sebiik/axoloti-preenfm2/preenfm2-master/hardware/screenshot.1560930870.jpg

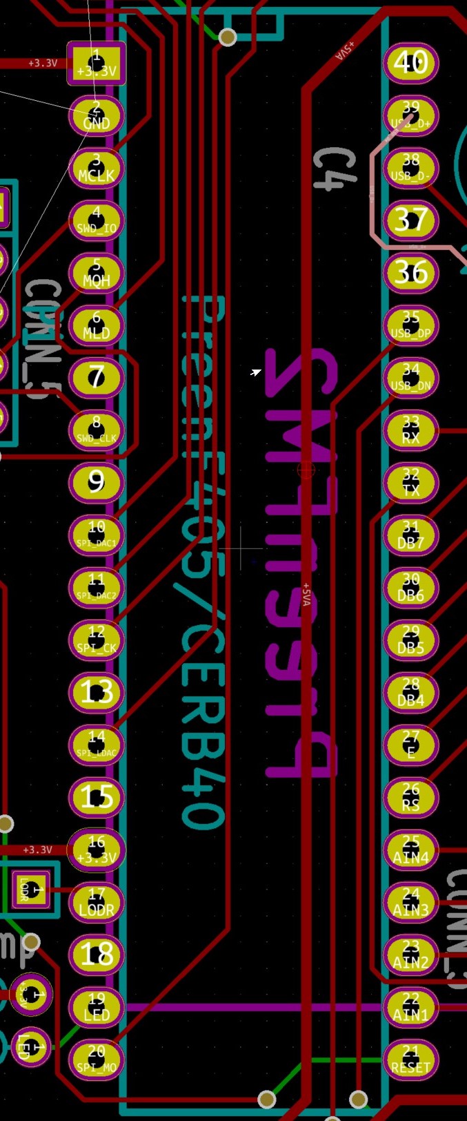
preenfm2-master/hardware/screenshot.1560930870.jpg
