sebiik/axoloti-preenfm2/preenfm2-master/hardware/VanDaalElectronics/20190225_163440.jpg

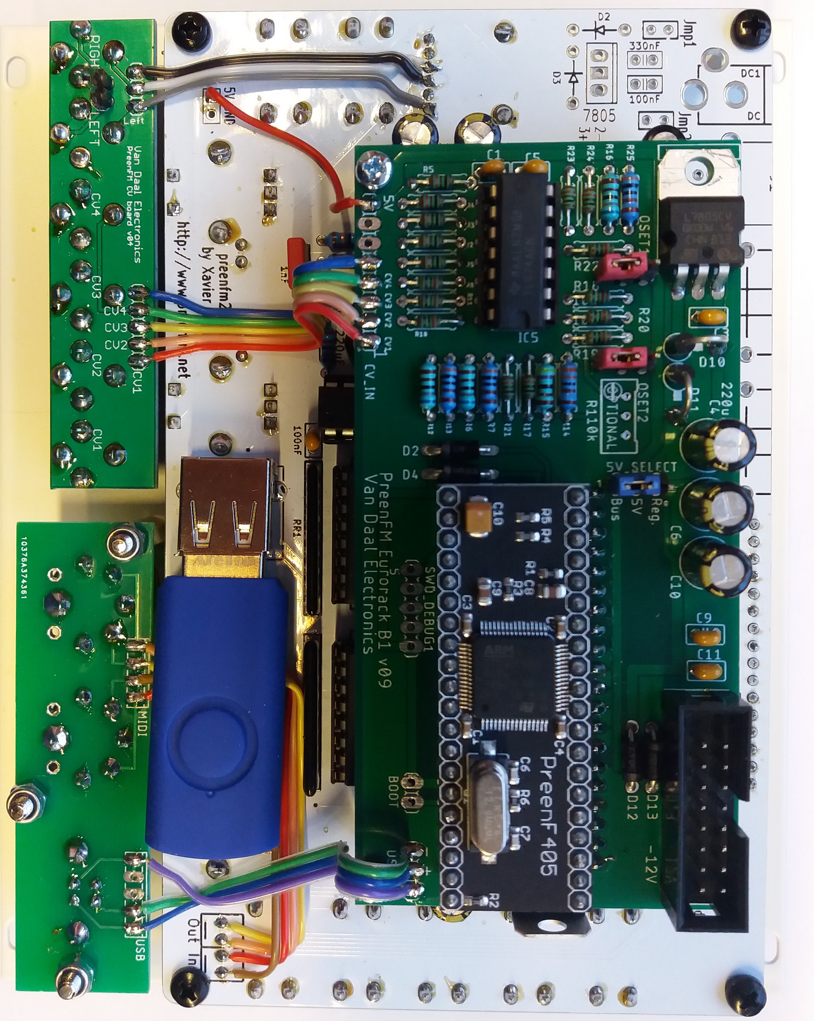
preenfm2-master/hardware/VanDaalElectronics/20190225_163440.jpg
