sebiik/axoloti-preenfm2/README.md

# axoloti-preenfm2

Nothing to see here, carry on.

Edit: Well actually I got Axoloti to work well on the PreenFM2 but it included some nasty hardware hacking and a new, proper DAC chip plugged onto the P405 board, all of which is why I won't release any further info on this project.
