sebiik/axoloti-preenfm2/axo-on-preenfm2-pinout.xlsx

Preen405 PIN | STM32F405 PIN | PREENFM2 FUNCTION | AXOLOTI FUNCTION | NOW HACKED IN
17 | BOOT0 | LOADER (JMP3) | BOOT0
1 | don’t care | 3V3 | 3V3
2 | don’t care | GND | GND
21 | NRST | #RESET | RST
26 | PA0 | LCD_RS | assignable
27 | PA1 | LCD_E | assignable
39 | PA11 | USB_DP | OTG_FS_DP
38 | PA12 | USB_DM | OTG_FS_DM
4 | PA13 | SWDIO | SWDIO
8 | PA14 | SWCLK | SWCLK
28 | PA2 | LCD_DB4 | assignable
29 | PA3 | LCD_DB5 | assignable
30 | PA4 | LCD_DB6 | assignable | now I2S3_WS
31 | PA5 | LCD_DB7 | assignable
6 | PA6 | SPI_MLD | assignable | To 74HC165
5 | PA7 | SPI_MQH | assignable | To 74HC165
3 | PA8 | MCLK | MCLK | To 74HC165
32 | PB10 | TX (MIDI_OUT) | assignable (Header X3) | UART3: DIN MIDI
33 | PB11 | RX (MIDI_IN) | nc | UART3: DIN MIDI
34 | PB14 | USBKey_DN | USB_HOST_DM |  | how to use?
35 | PB15 | USBKey_DP | USB_HOST_DP |  | how to use?
12 | PB3 | SPI_CK | assignable (SPI3_SCK) | now I2S3_CK | Was: MCP4922 SCK
10 | PB4 | SPI_DAC1 | assignable (SPI3_MISO) |  | Was: MCP4922 CS1
20 | PB5 | SPI_MO | Switch 1 (PB5/BOOT0) | now I2S3_SD | Was: MCP4922 MO
19 | PB6 | LED | assignable
18 | PB7 | nc | assignable
16 | PB8 | 3V3 (for board recognition) | assignable (I2C1_SCL)
11 | PB9 | SPI_DAC2 | assignable (I2C1_SDA) |  | Was: MCP4922 CS2
22 | PC0 | assignable(AIN1) | assignable | gate in
23 | PC1 | assignable(AIN2) | assignable | CV in
7 | PC10 | nc | SDIO_D2 | SD card D2
9 | PC11 | nc | SDIO_D3 | SD card D3
14 | PC12 | SPI_LDAC | SDIO_CK | SD card CK | Was: MCP4922 LDAC
15 | PC13 | nc | nc (weak)
24 | PC2 | assignable(AIN3) | assignable
25 | PC3 | assignable(AIN4) | assignable
36 | PC6 | nc | nc | now LCD_DB6
37 | PC7 | nc | nc | now I2S3_MCK
40 | PC8 | nc | SDIO_D0 | SD card D0
13 | PD2 | nc | SDIO_CMD | SD card CMD
*41 | PC9 | Pull-up | SDIO_D1 | SD card D1
 |  |  |  |  |  | D2 | D3 | CMD | VSS | VDD | CLK | VSS | D0 | D1
 |  |  |  |  |  |  | 1 | 2 | 3 | 4 | 5 | 6 | 7 | 8
 |  |  |  |  |  | 9
 |  |  |  |  |  |  |  |  | SD CARD
