sebiik/axoloti-preenfm2/preenfm2-master/hardware/preenF405/Preen40.pdf

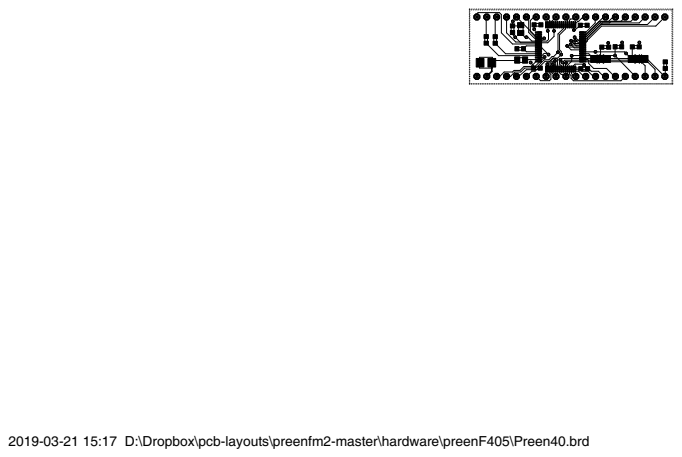
[picture p12: page 1]

2019-03-21 15:17 D:\Dropbox\pcb-layouts\preenfm2-master\hardware\preenF405\Preen40.brd
