sebiik/axoloti-preenfm2/preenfm2-master/hardware/VanDaalElectronics/CV_converter_v06.brd.pdf

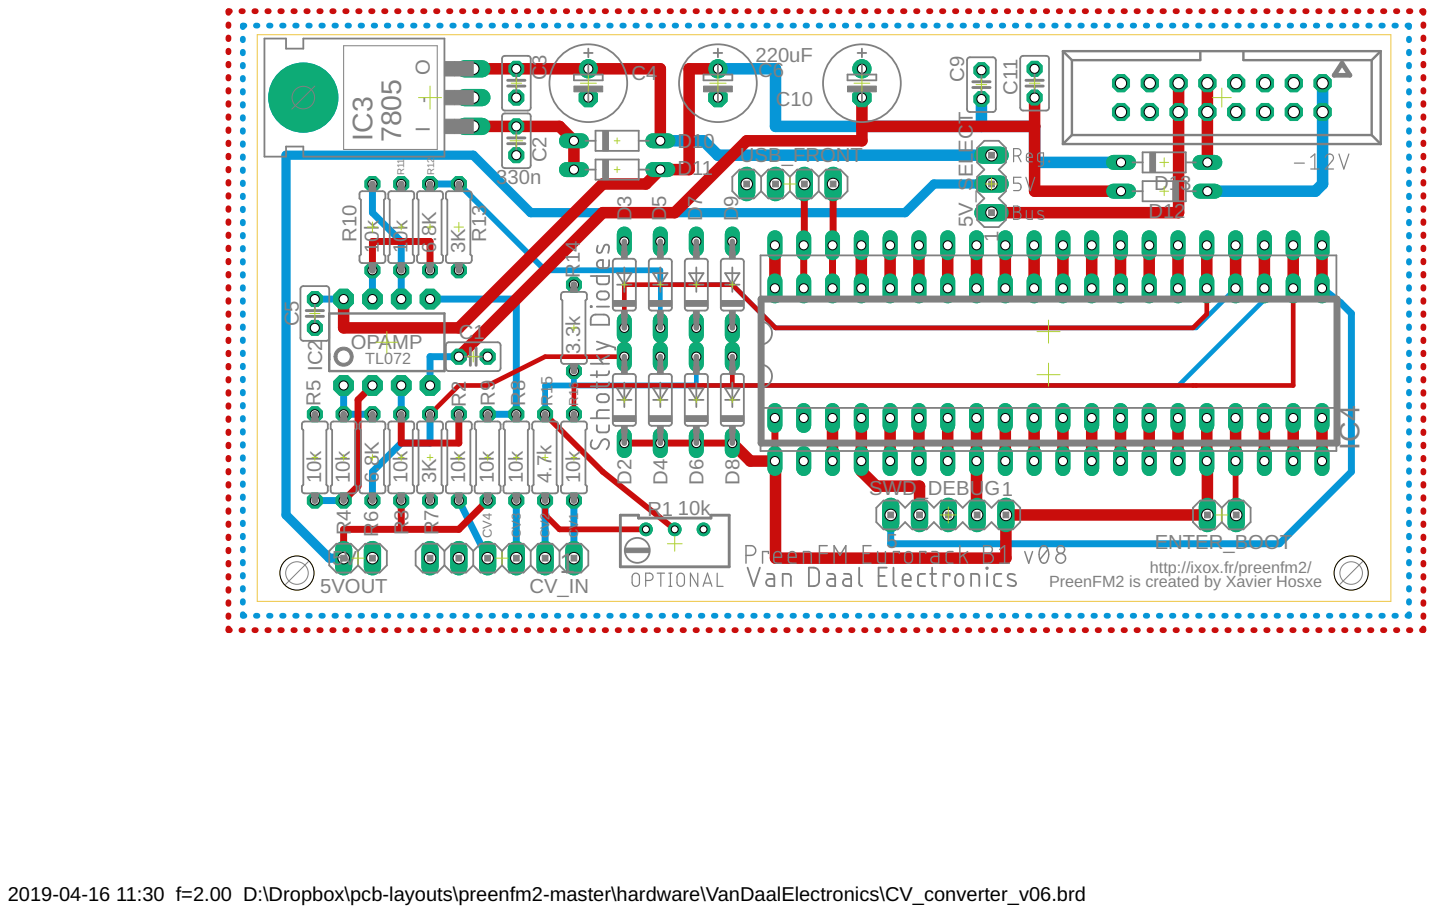
[picture p13: page 1]

PreenFM2 is created by Xavier Hosxe

2019-04-16 11:30 f=2.00 D:\Dropbox\pcb-layouts\preenfm2-master\hardware\VanDaalElectronics\CV_converter_v06.brd
