sebiik/axoloti-preenfm2/_done/kicad-cs4354-daughterboard/cs4354-daughterboard.pdf

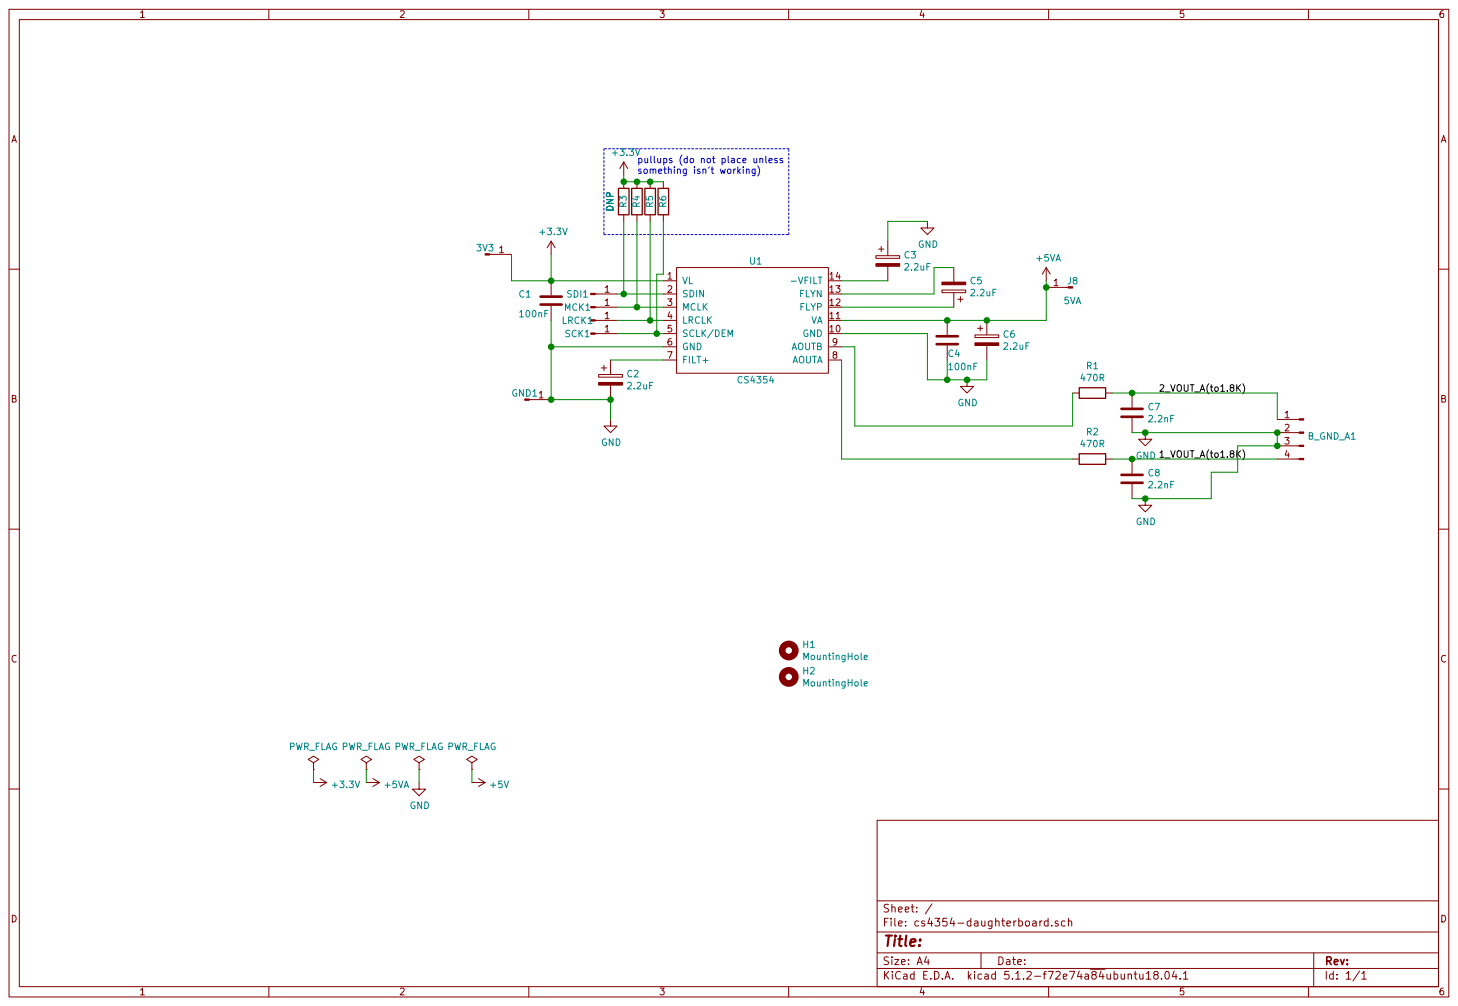
[picture p14: page 1]

something isn't working) +3.3V
pullups (do not place unless

File: cs4354-daughterboard.sch Sheet: /
Id: 1/1 Title:
