sebiik/axoloti-preenfm2/preenfm2-master/hardware/preenF405/Preen40_schem.pdf

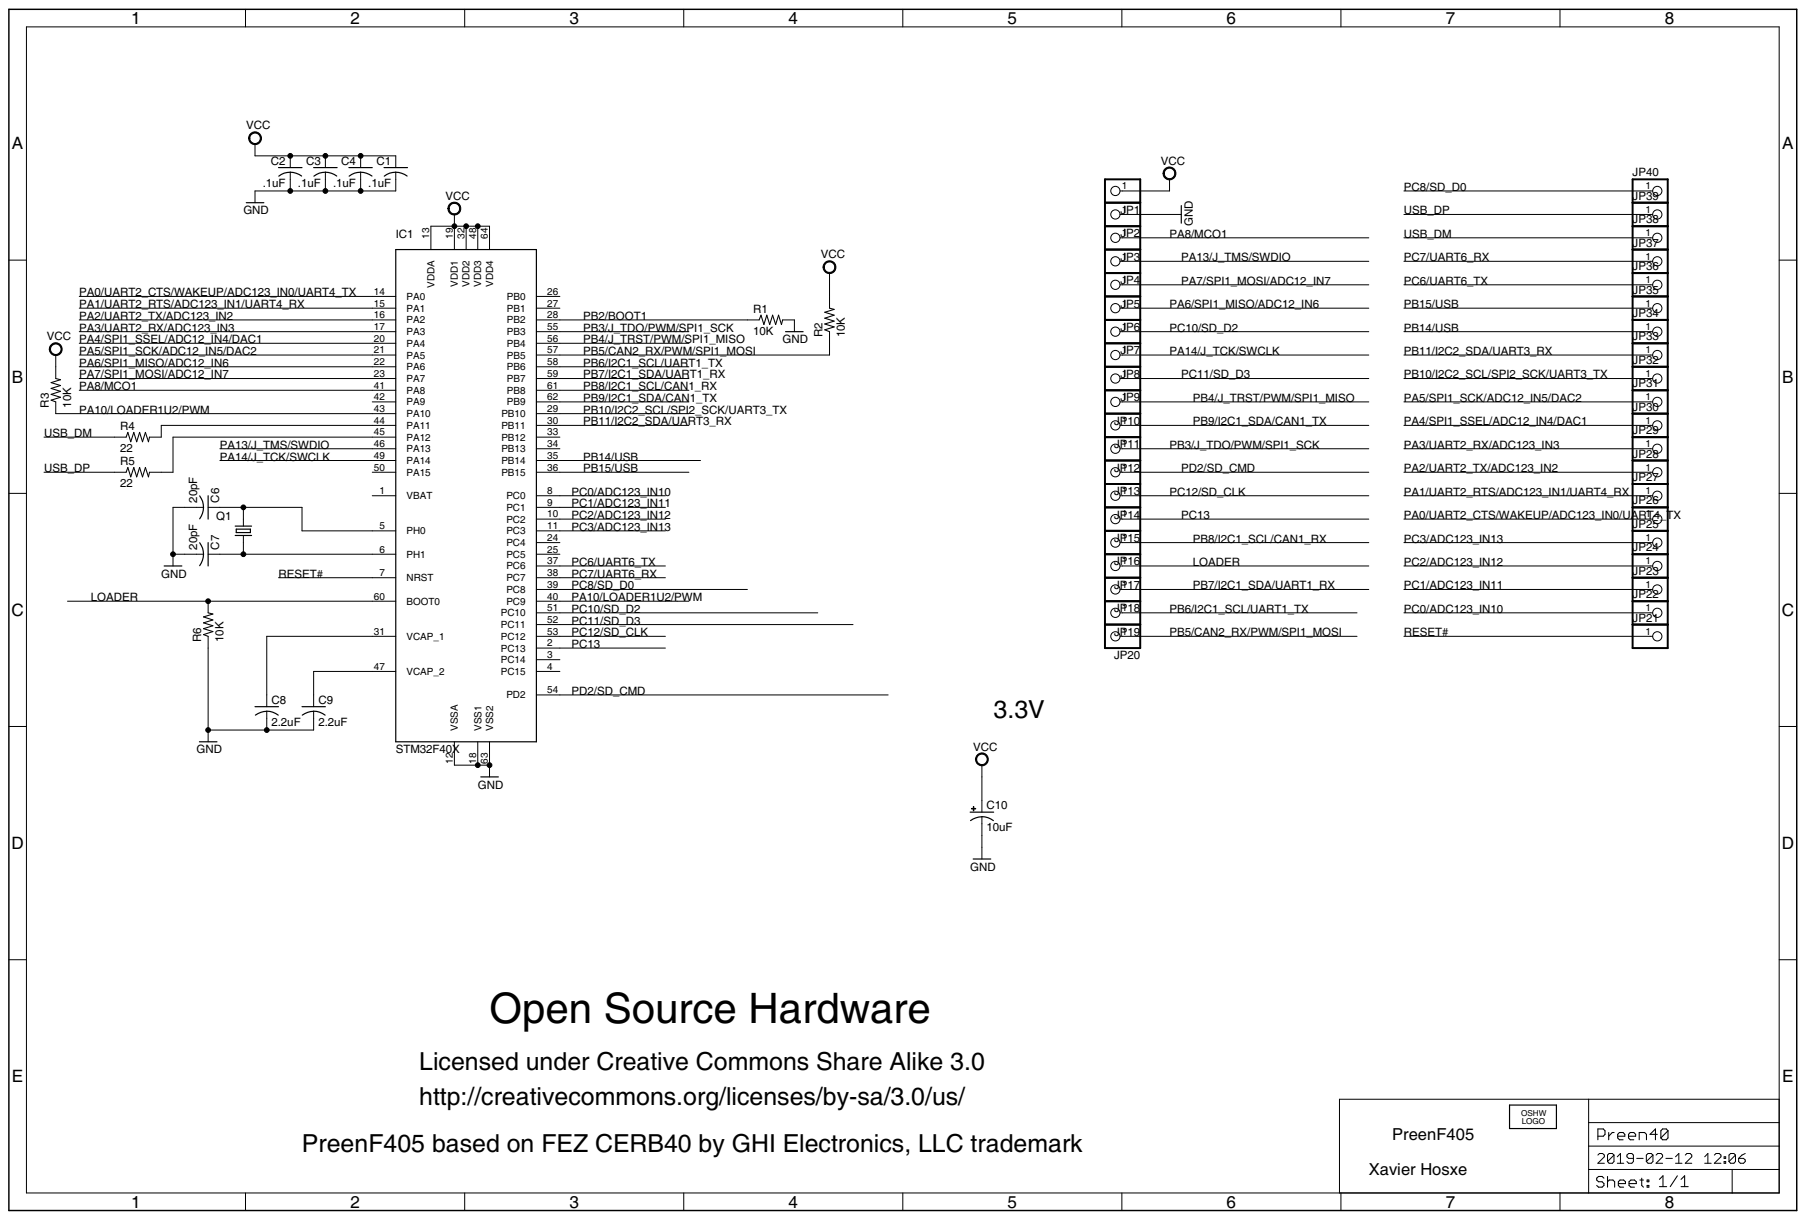
[picture p15: page 1]

Xavier Hosxe Open Source Hardware

Licensed under Creative Commons Share Alike 3.0
http://creativecommons.org/licenses/by-sa/3.0/us/

PreenF405 based on FEZ CERB40 by GHI Electronics, LLC trademark
