sebiik/axoloti-preenfm2/preenfm2-master/hardware/VanDaalElectronics/CV_converter_v06.sch.pdf

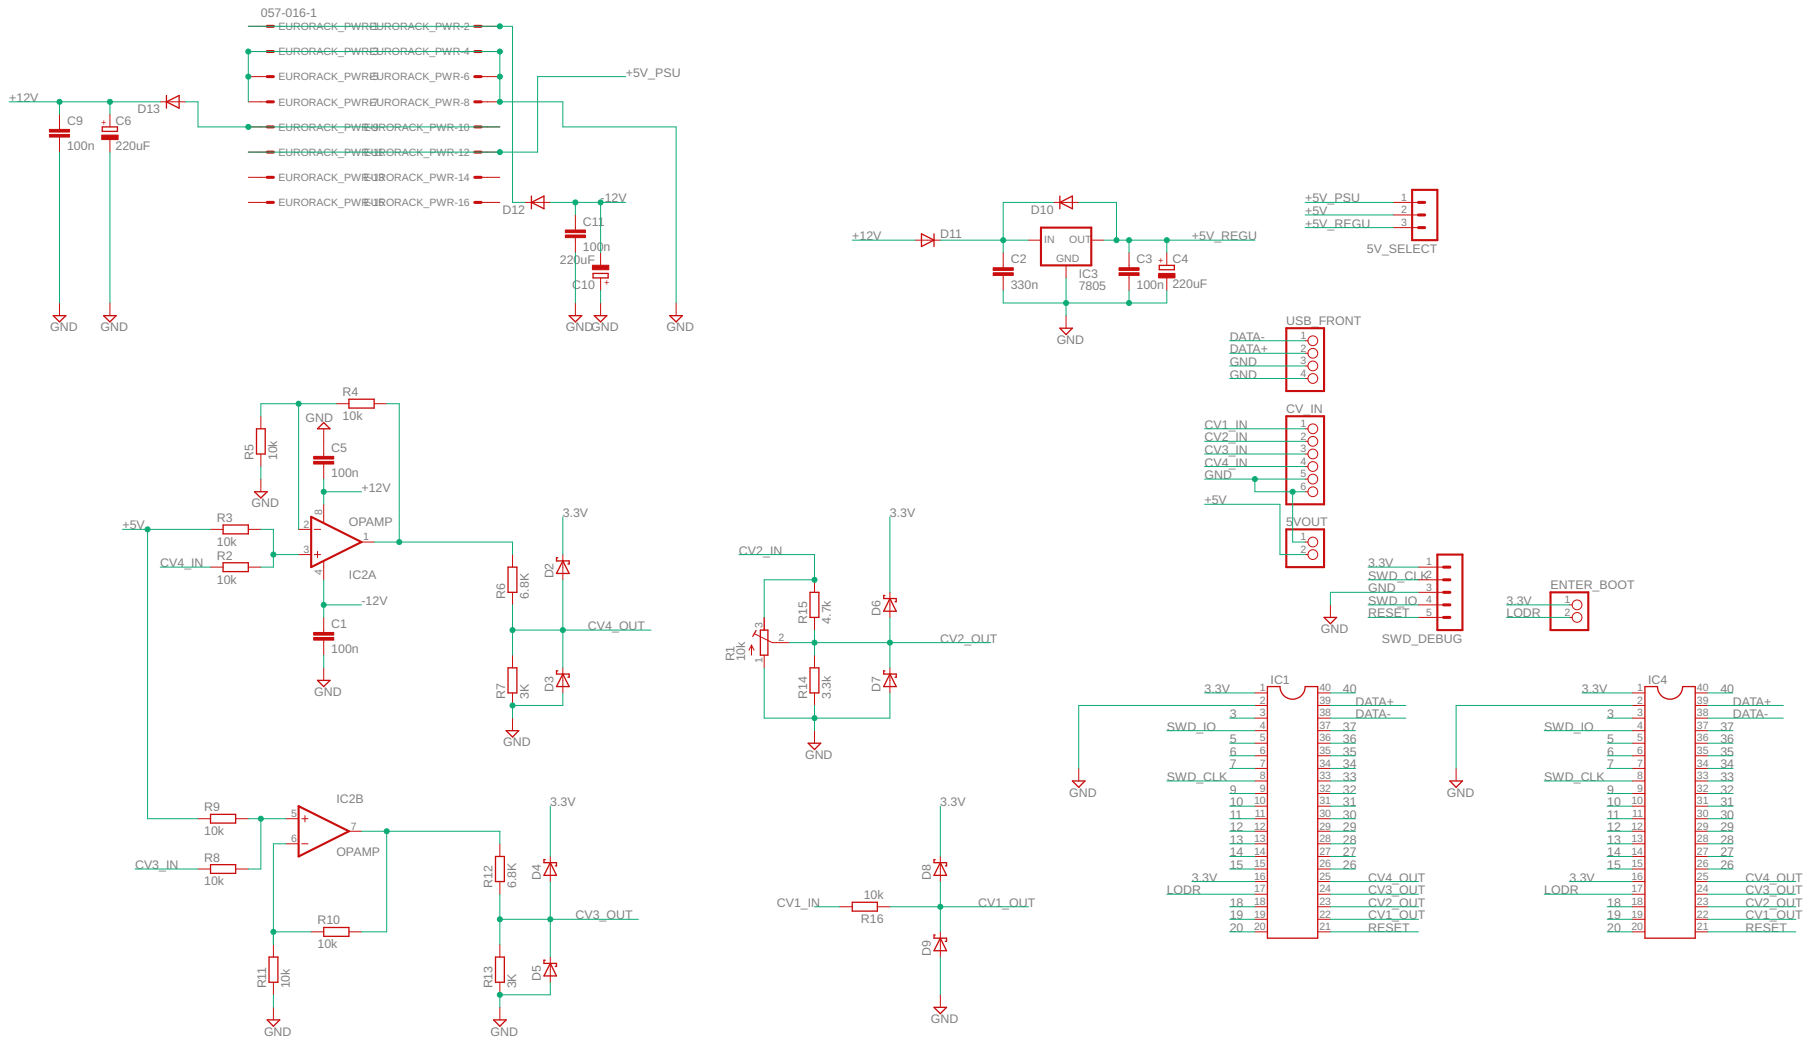
[picture p16: page 1]
