sebiik/axoloti-preenfm2/preenfm2-master/preenfm2-pcb.pdf

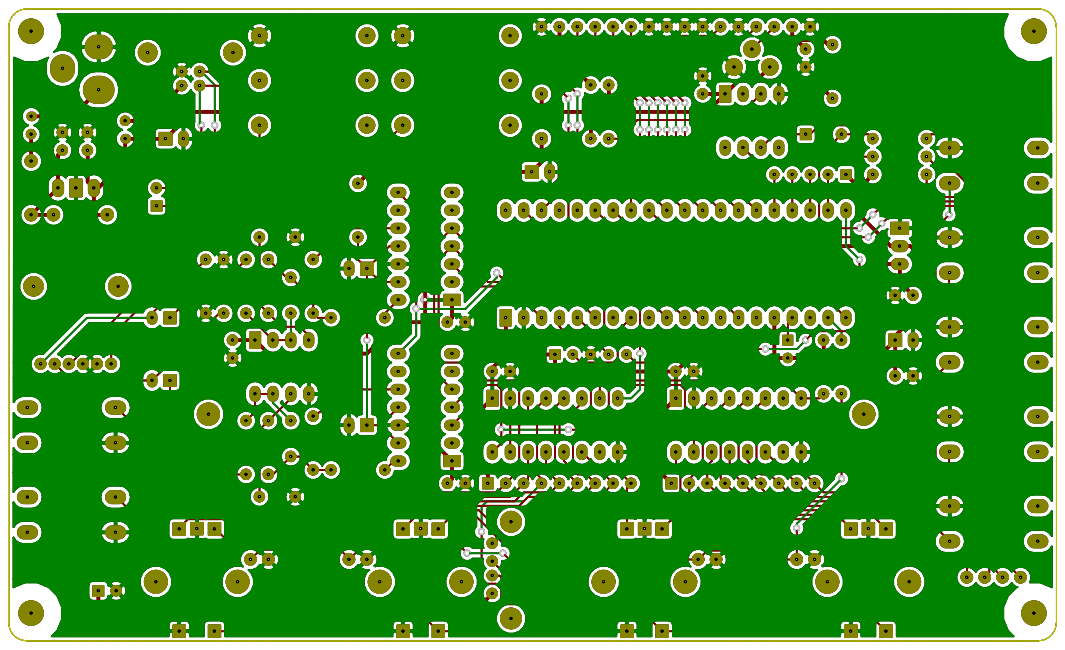
[picture p17: page 1]
