sebiik/axoloti-preenfm2/preenfm2-master/preenfm2-schem.pdf

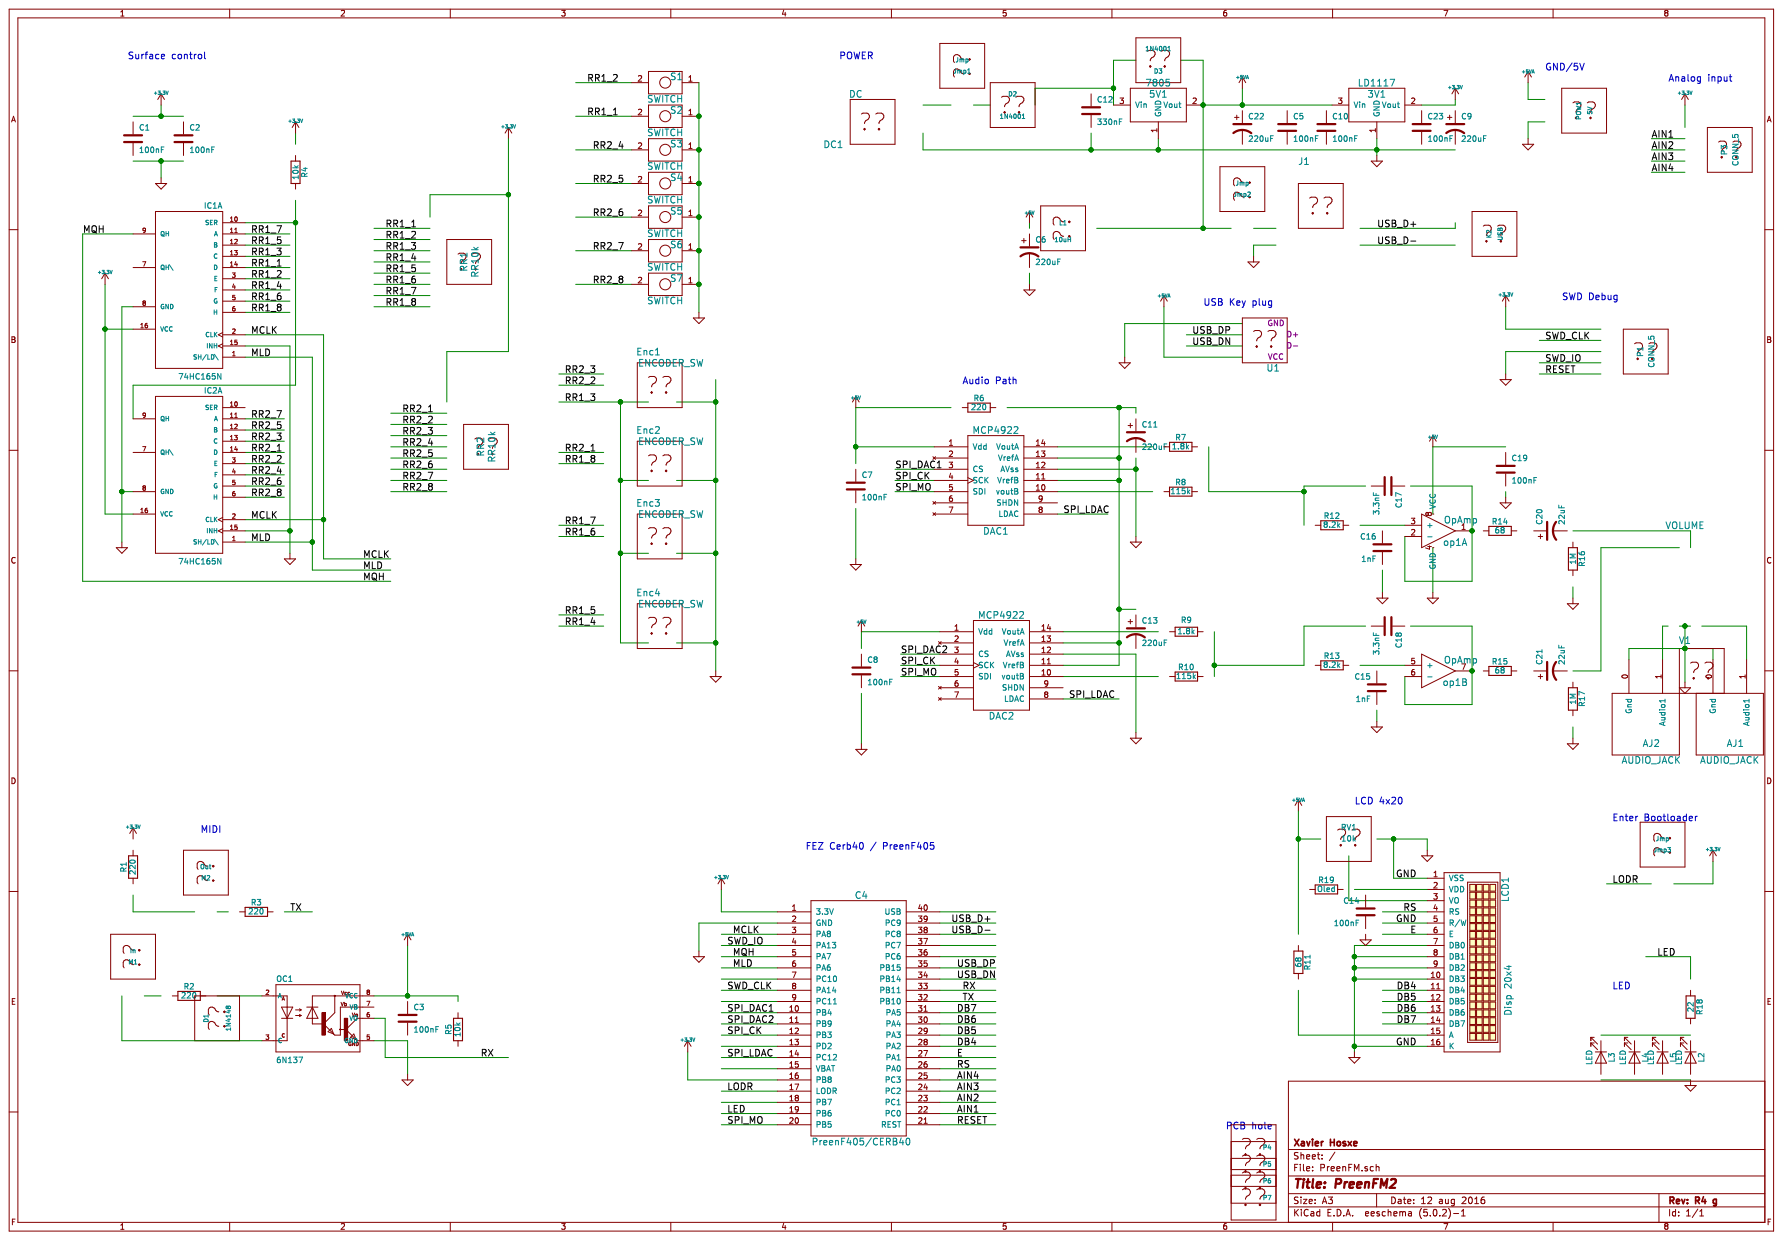
[picture p18: page 1]
