sebiik/axoloti-preenfm2/_done/kicad-cs4354-daughterboard/gerber/cs4354-daughterboard-B_Cu.pdf

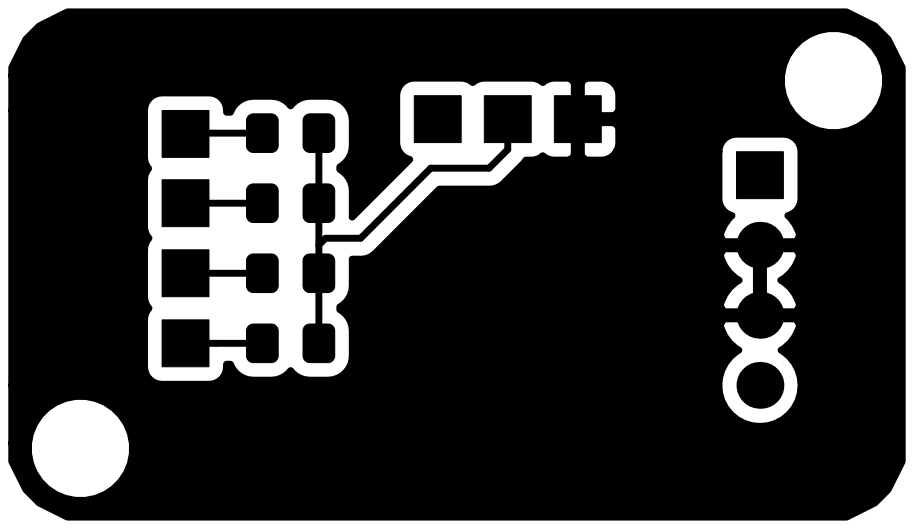
[picture p19: page 1]
