sebiik/axoloti-preenfm2/_done/kicad-cs4354-daughterboard/gerber/cs4354-daughterboard-B_Mask.pdf

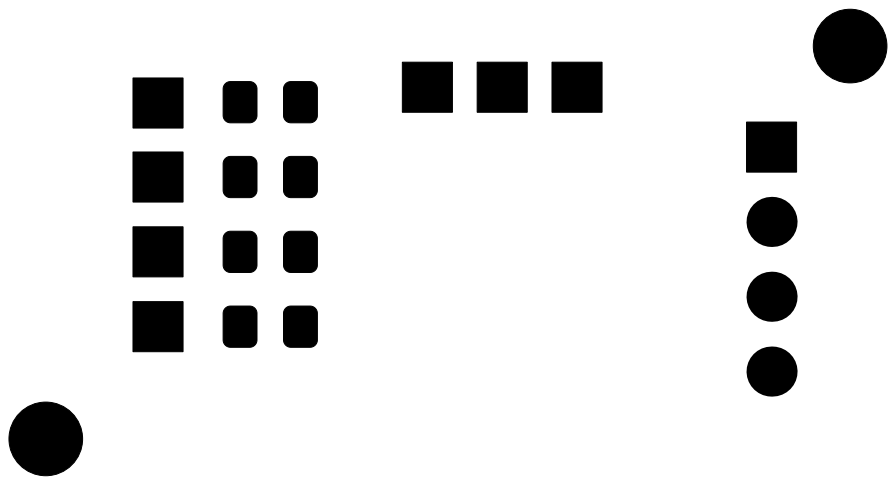
[picture p20: page 1]
