sebiik/axoloti-preenfm2/_done/kicad-cs4354-daughterboard/gerber/cs4354-daughterboard-B_Paste.pdf

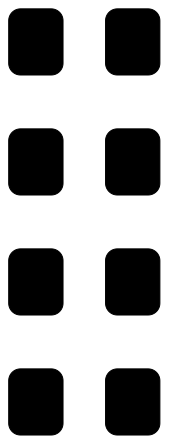
[picture p21: page 1]
