sebiik/axoloti-preenfm2/_done/kicad-cs4354-daughterboard/gerber/cs4354-daughterboard-B_SilkS.pdf

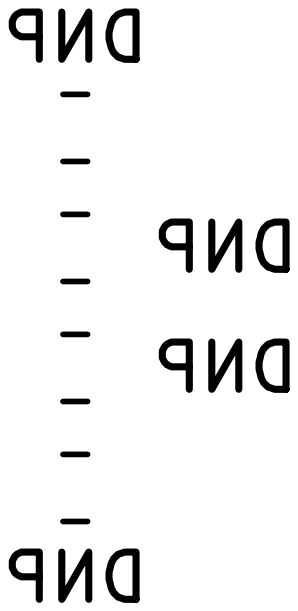
[picture p22: page 1]

DNP DNP
