sebiik/axoloti-preenfm2/_done/kicad-cs4354-daughterboard/gerber/cs4354-daughterboard-Edge_Cuts.pdf

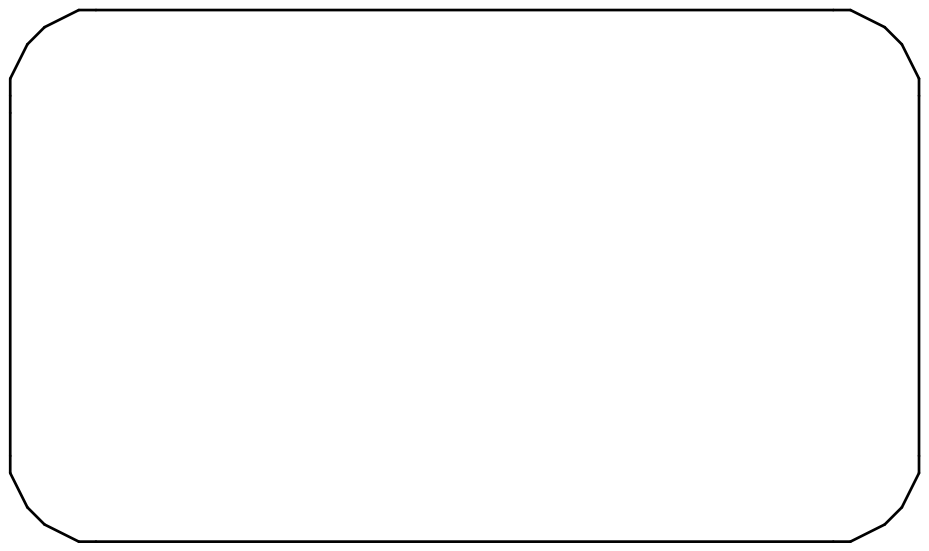
[picture p23: page 1]
