sebiik/axoloti-preenfm2/_done/kicad-cs4354-daughterboard/gerber/cs4354-daughterboard-F_Cu.pdf

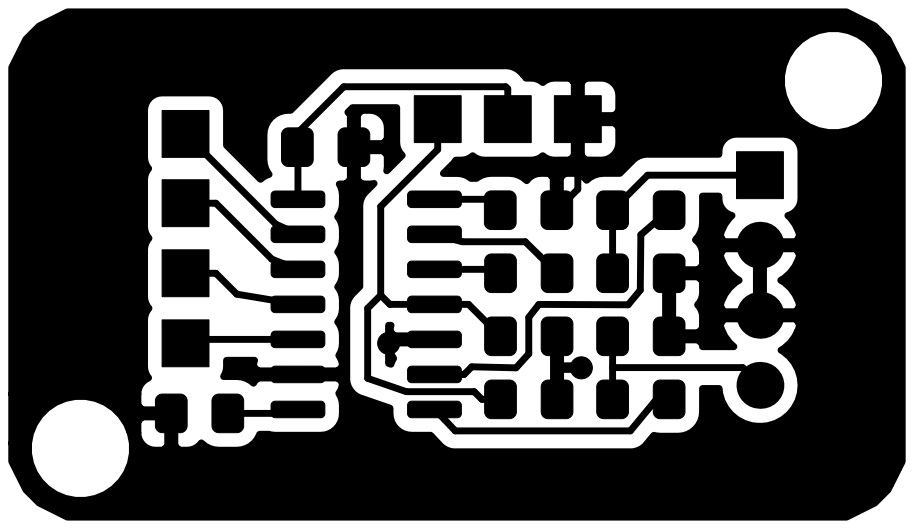
[picture p24: page 1]
