sebiik/axoloti-preenfm2/_done/kicad-cs4354-daughterboard/gerber/cs4354-daughterboard-F_Mask.pdf

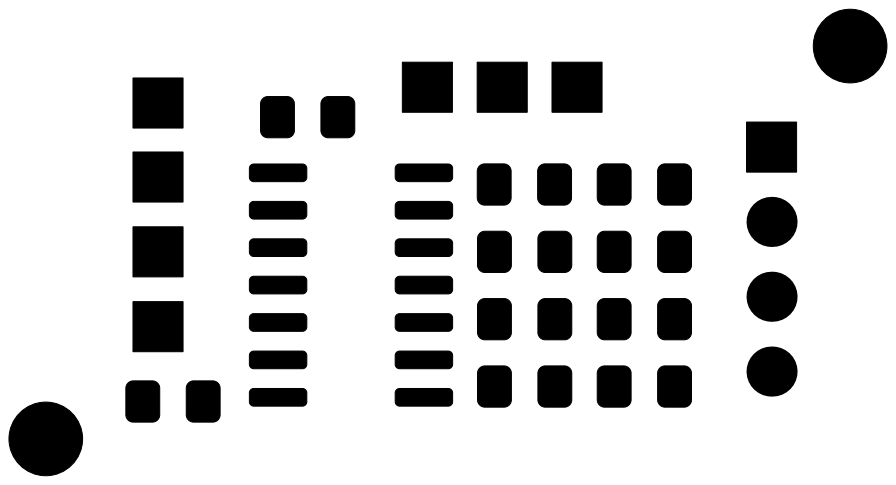
[picture p25: page 1]
