sebiik/axoloti-preenfm2/_done/kicad-cs4354-daughterboard/gerber/cs4354-daughterboard-F_Paste.pdf

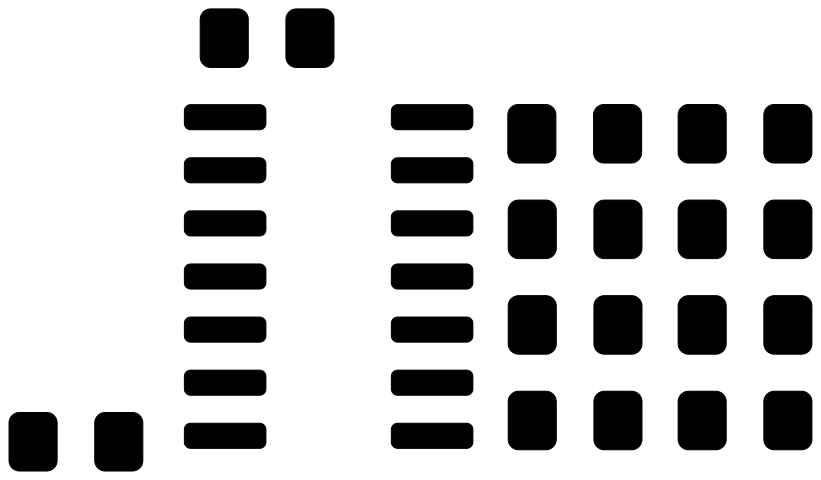
[picture p26: page 1]
