sebiik/axoloti-preenfm2/_done/kicad-cs4354-daughterboard/gerber/cs4354-daughterboard-F_SilkS.pdf

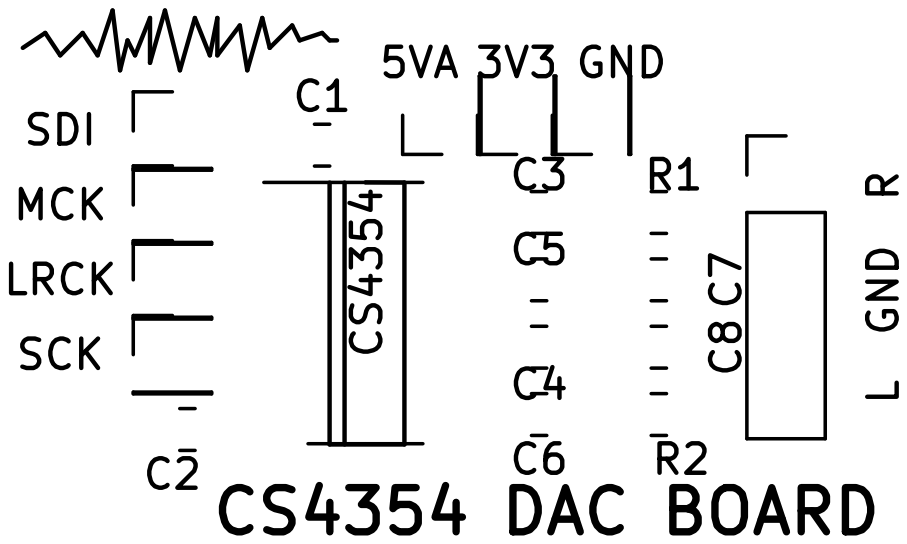
[picture p27: page 1]
