sebiik/axoloti-preenfm2/_done/kicad-cs4354-daughterboard/cs4354-daughterboard.kicad_pcb

## KiCad design _done/kicad-cs4354-daughterboard/cs4354-daughterboard.kicad_pcb (2019-07-05)

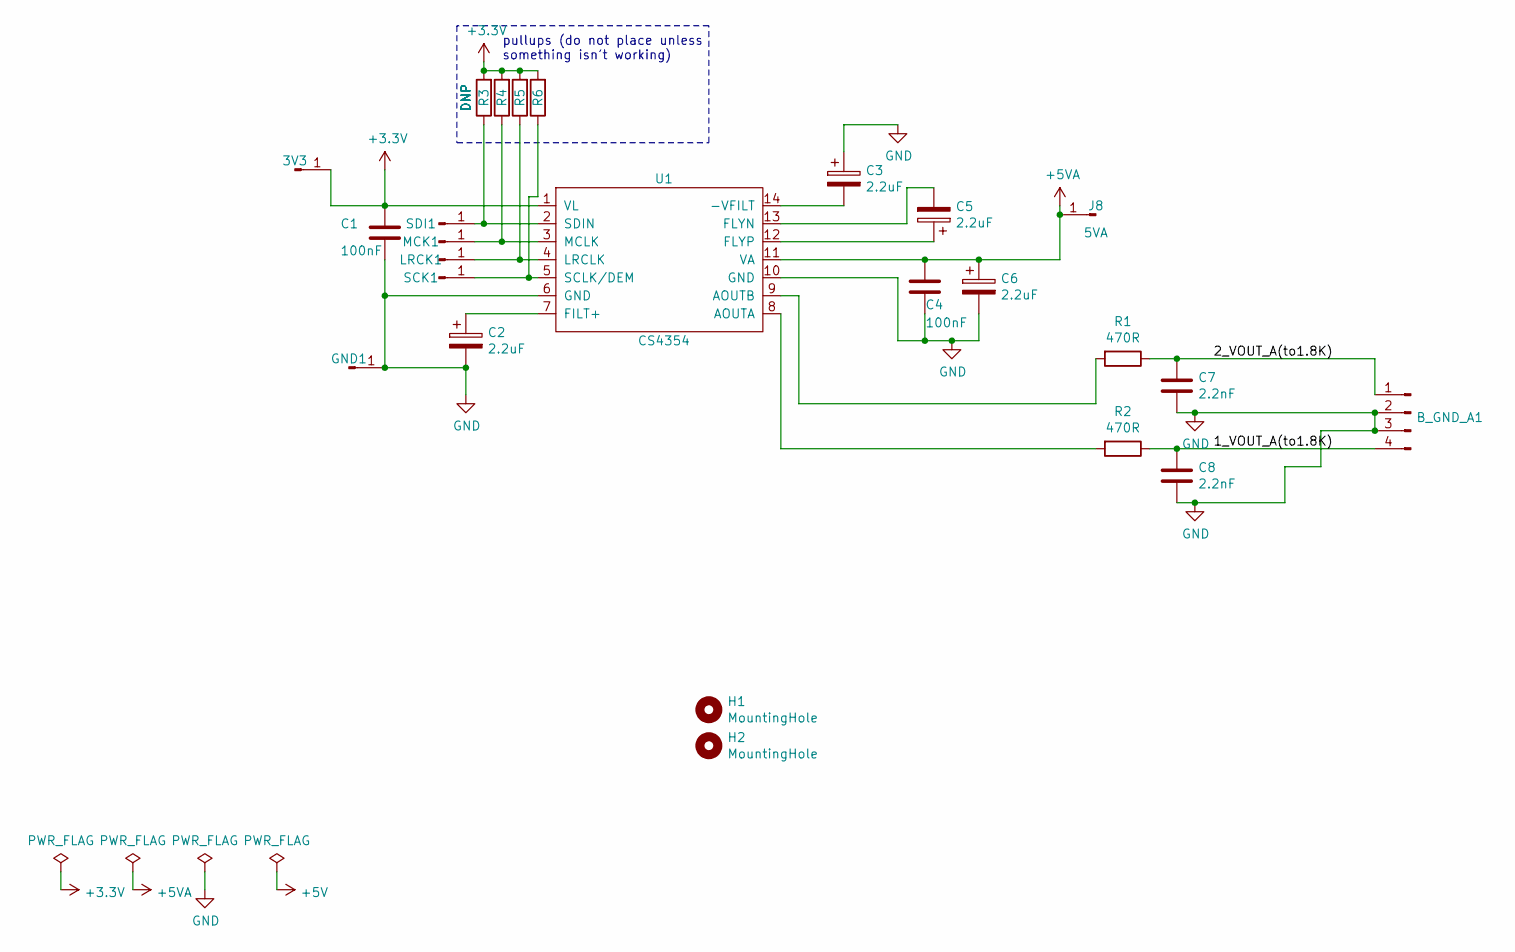
[picture p28: schematic cs4354-daughterboard.sch]

Parts:
3V3: 3V3; PinHeader_1x01_P2.54mm_Vertical
B_GND_A1: L GND R; PinHeader_1x04_P2.54mm_Vertical
C1, C4: 100nF; C_0805_2012Metric_Pad1.15x1.40mm_HandSolder
C2, C3, C5, C6: 2.2uF; C_0805_2012Metric_Pad1.15x1.40mm_HandSolder
C7, C8: 2.2nF; C_0805_2012Metric_Pad1.15x1.40mm_HandSolder
GND1: GND; PinHeader_1x01_P2.54mm_Vertical
H1, H2: MountingHole; MountingHole_2.5mm
J8: 5VA; PinHeader_1x01_P2.54mm_Vertical
LRCK1: LRCK; PinHeader_1x01_P2.54mm_Vertical
MCK1: MCK; PinHeader_1x01_P2.54mm_Vertical
R1, R2: 470R; R_0805_2012Metric_Pad1.15x1.40mm_HandSolder
R3, R4, R5, R6: DNP; R_0805_2012Metric_Pad1.15x1.40mm_HandSolder
SCK1: SCK; PinHeader_1x01_P2.54mm_Vertical
SDI1: SDI; PinHeader_1x01_P2.54mm_Vertical
U1: CS4354; SOIC-14_3.9x8.7mm_P1.27mm

Connections:
+3V3: 3V3.1, C1.1, R3.2, R4.2, R5.2, R6.2, U1.1 (VL)
+5VA: C4.1, C6.1, J8.1, U1.11 (VA)
/1_VOUT_A(to1.8K): B_GND_A1.4, C8.1, R2.1
/2_VOUT_A(to1.8K): B_GND_A1.1, C7.1, R1.1
GND: B_GND_A1.2, B_GND_A1.3, C1.2, C2.2, C3.1, C4.2, C6.2, C7.2, C8.2, GND1.1, U1.6 (GND), U1.10 (GND)
unnamed: C2.1, U1.7 (FILT+)
unnamed: C3.2, U1.14 (-VFILT)
unnamed: C5.1, U1.12 (FLYP)
unnamed: C5.2, U1.13 (FLYN)
unnamed: LRCK1.1, R5.1, U1.4 (LRCLK)
unnamed: MCK1.1, R4.1, U1.3 (MCLK)
unnamed: R1.2, U1.9 (AOUTB)
unnamed: R2.2, U1.8 (AOUTA)
unnamed: R3.1, SDI1.1, U1.2 (SDIN)
unnamed: R6.1, SCK1.1, U1.5 (SCLK/DEM)

Notes on the sheet:
pullups (do not place unless something isn't working)

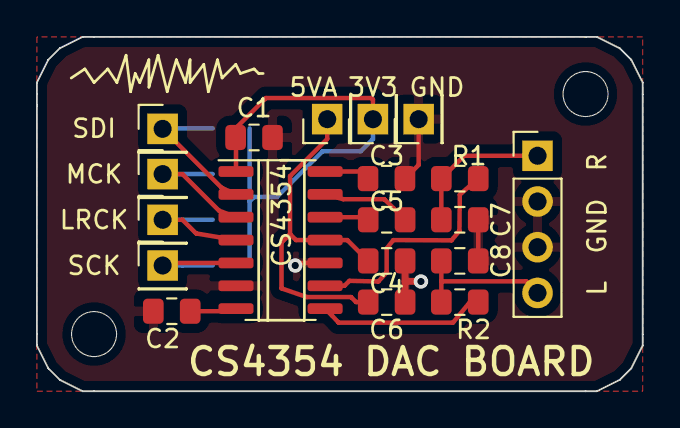
[picture p29: board cs4354-daughterboard.kicad_pcb from above]

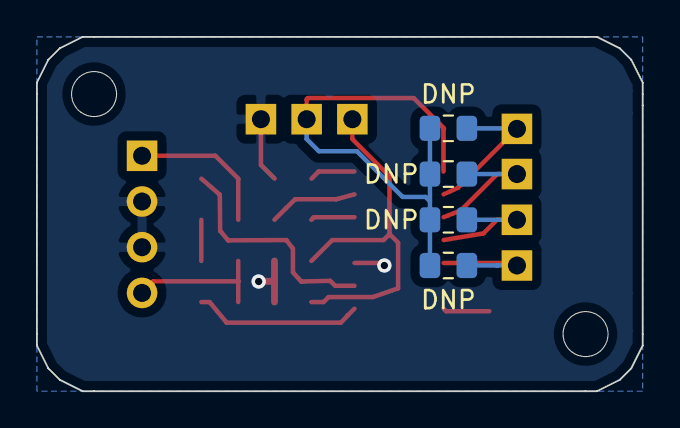
[picture p30: board cs4354-daughterboard.kicad_pcb from below]

Board: 2 copper layers, 33.7 x 19.7 mm, 25 parts (4 on the bottom side), 15 nets.
