sebiik/axoloti-preenfm2/preenfm2-master/hardware/PCB/PreenFM.kicad_pcb

## KiCad design preenfm2-master/hardware/PCB/PreenFM.kicad_pcb (2019-07-02)

Schematic: PreenFM.sch, PreenFM2

Parts:
3V1: LD1117
5V1: 7805
AJ1, AJ2: AUDIO_JACK
C1, C2, C3, C5, C7, C8, C10, C14, C19, C23: 100nF
C4: PreenF405/CERB40
C6, C9, C11, C13, C22: 220uF
C12: 330nF
C15, C16: 1nF
C17, C18: 3.3nF
C20, C21: 22uF
D1: 1N4148
D2, D3: 1N4001
DAC1, DAC2: MCP4922
DC1: DC
Enc1, Enc2, Enc3, Enc4: ENCODER_SW
IC1, IC2: 74HC165N; 74xx-eu-DIL16
J1: USB_1
Jmp1, Jmp2, Jmp3: Jmp
K2: USB
L1: 10uH
L2, L3, L4, L5: LED
LCD1: Disp 20x4
M1: In
M2: Out
OC1: 6N137; optocoupler-DIL08
P1, P3: CONN_5
P4, P5, P6, P7: CONN_1
POW1: 5V
R1, R2, R3, R6: 220
R4, R5: 10k
R7, R9: 1.8k
R8, R10: 115k
R11, R14, R15: 68
R12, R13: 8.2k
R16, R17: 1M
R18: 22
R19: Oled
RR1, RR2: RR10k
RV1: 10k
S1, S2, S3, S4, S5, S6, S7: SWITCH
U1: USBKey
V1: VOLUME
op1: OpAmp

Connections:
+3.3V: 3V1.2 (Vout), C1.1, C2.1, C4.1 (3.3V), C4.16 (PB8), C9.1, C23.1, IC1.16 (VCC), IC2.16 (VCC), Jmp3.2, P1.1, P3.1, R1.2, R4.1, RR1.1, RR2.1
+5V: C6.1, C7.1, C8.1, C19.1, DAC1.1 (Vdd), DAC2.1 (Vdd), L1.2, R6.1, op1.8 (VCC)
+5VA: 3V1.3 (Vin), 5V1.2 (Vout), C3.1, C5.1, C10.1, C22.1, D3.1 (K), Jmp2.1, L1.1, OC1.8 (VCC), POW1.1, R5.2, R11.2, R19.2, RV1.3, U1.1
/AIN1: C4.22 (PC0), P3.2
/AIN2: C4.23 (PC1), P3.3
/AIN3: C4.24 (PC2), P3.4
/AIN4: C4.25 (PC3), P3.5
/DB4: C4.28 (PA2), LCD1.11 (DB4)
/DB5: C4.29 (PA3), LCD1.12 (DB5)
/DB6: C4.30 (PA4), LCD1.13 (DB6)
/DB7: C4.31 (PA5), LCD1.14 (DB7)
/E: C4.27 (PA1), LCD1.6 (E)
/LED: C4.19 (PB6), R18.1
/LODR: C4.17 (LODR), Jmp3.1
/MCLK: C4.3 (PA8), IC1.2 (CLK), IC2.2 (CLK)
/MLD: C4.6 (PA6), IC1.1 (SH/LD\), IC2.1 (SH/LD\)
/MQH: C4.5 (PA7), IC1.9 (QH)
/RESET: C4.21 (REST), P1.5
/RR1_1: IC1.14 (D), RR1.2, S2.2
/RR1_2: IC1.3 (E), RR1.3, S1.2
/RR1_3: Enc1.3, Enc2.3, Enc3.3, Enc4.3, IC1.13 (C), RR1.4
/RR1_4: Enc4.2 (Pin2), IC1.4 (F), RR1.5
/RR1_5: Enc4.0 (Pin1), IC1.12 (B), RR1.6
/RR1_6: Enc3.2 (Pin2), IC1.5 (G), RR1.7
/RR1_7: Enc3.0 (Pin1), IC1.11 (A), RR1.8
/RR1_8: Enc2.2 (Pin2), IC1.6 (H), RR1.9
/RR2_1: Enc2.0 (Pin1), IC2.14 (D), RR2.2
/RR2_2: Enc1.2 (Pin2), IC2.3 (E), RR2.3
/RR2_3: Enc1.0 (Pin1), IC2.13 (C), RR2.4
/RR2_4: IC2.4 (F), RR2.5, S3.2
/RR2_5: IC2.12 (B), RR2.6, S4.2
/RR2_6: IC2.5 (G), RR2.7, S5.2
/RR2_7: IC2.11 (A), RR2.8, S6.2
/RR2_8: IC2.6 (H), RR2.9, S7.2
/RS: C4.26 (PA0), LCD1.4 (RS)
/RX: C4.33 (PB11), OC1.6 (VO), R5.1
/SPI_CK: C4.12 (PB3), DAC1.4 (SCK), DAC2.4 (SCK)
/SPI_DAC1: C4.10 (PB4), DAC1.3 (CS)
/SPI_DAC2: C4.11 (PB9), DAC2.3 (CS)
/SPI_LDAC: C4.14 (PC12), DAC1.8 (LDAC), DAC2.8 (LDAC)
/SPI_MO: C4.20 (PB5), DAC1.5 (SDI), DAC2.5 (SDI)
/SWD_CLK: C4.8 (PA14), P1.2
/SWD_IO: C4.4 (PA13), P1.4
/TX: C4.32 (PB10), R3.2
/USB_D+: C4.39 (PC9), J1.3, K2.1
/USB_D-: C4.38 (PC8), J1.2, K2.2
/USB_DN: C4.34 (PB14), U1.2
/USB_DP: C4.35 (PB15), U1.3
GND: 3V1.1 (GND), 5V1.1 (GND), AJ1.0 (Gnd), AJ2.0 (Gnd), C1.2, C2.2, C3.2, C4.2 (GND), C5.2, C6.2, C7.2, C8.2, C9.2, C10.2, C11.2, C12.2, C13.2, C14.2, C15.2, C16.2, C19.2, C22.2, C23.2, DAC1.12 (AVss), DAC2.12 (AVss), DC1.1, Enc1.1 (GND), Enc1.4, Enc2.1 (GND), Enc2.4, Enc3.1 (GND), Enc3.4, Enc4.1 (GND), Enc4.4, IC1.8 (GND), IC1.15 (INH), IC2.8 (GND), IC2.15 (INH), J1.4, L2.2 (A), L3.2 (A), L4.2 (A), L5.2 (A), LCD1.1 (VSS), LCD1.5 (R/W), LCD1.7 (DB0), LCD1.8 (DB1), LCD1.9 (DB2), LCD1.10 (DB3), LCD1.16 (K), OC1.5 (GND), P1.3, POW1.2, R16.2, R17.2, RV1.1, S1.1, S2.1, S3.1, S4.1, S5.1, S6.1, S7.1, U1.4, V1.1, V1.4, op1.4 (GND)
unnamed: IC1.10 (SER), IC2.9 (QH), R4.2
unnamed: AJ1.1 (Audio1), V1.5
unnamed: M2.1, R1.1
unnamed: C17.1, R14.1, op1.1, op1.2 (-)
unnamed: C18.1, R15.1, op1.6 (-), op1.7
unnamed: C20.1, R14.2
unnamed: C21.1, R15.2
unnamed: DAC1.14 (VoutA), R7.1
unnamed: C15.1, R13.2, op1.5 (+)
unnamed: DAC2.14 (VoutA), R9.1
unnamed: DAC2.10 (voutB), R10.1
unnamed: DAC1.10 (voutB), R8.1
unnamed: C17.2, R7.2, R8.2, R12.1
unnamed: AJ2.1 (Audio1), V1.2
unnamed: C20.2, R16.1, V1.6
unnamed: D2.1 (K), Jmp1.2
unnamed: DC1.3, Jmp1.1
unnamed: LCD1.15 (A), R11.1
unnamed: C16.1, R12.2, op1.3 (+)
unnamed: J1.1, Jmp2.2
unnamed: LCD1.3 (VO), RV1.2
unnamed: M1.1, R2.1
unnamed: M2.2, R3.1
unnamed: D1.1 (K), M1.2, OC1.3 (C)
unnamed: C18.2, R9.2, R10.2, R13.1
unnamed: 5V1.3 (Vin), C12.1, D2.2 (A), D3.2 (A)
unnamed: C21.2, R17.1, V1.3
unnamed: C11.1, C13.1, DAC1.11 (VrefB), DAC1.13 (VrefA), DAC2.11 (VrefB), DAC2.13 (VrefA), R6.2
unnamed: L2.1 (K), L3.1 (K), L4.1 (K), L5.1 (K), R18.2

Notes on the sheet:
GND/5V
Analog input
Audio Path
LCD 4x20
PCB hole
USB Key plug
SWD Debug
MIDI
POWER
Surface control
FEZ Cerb40 / PreenF405
LED
Enter Bootloader

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
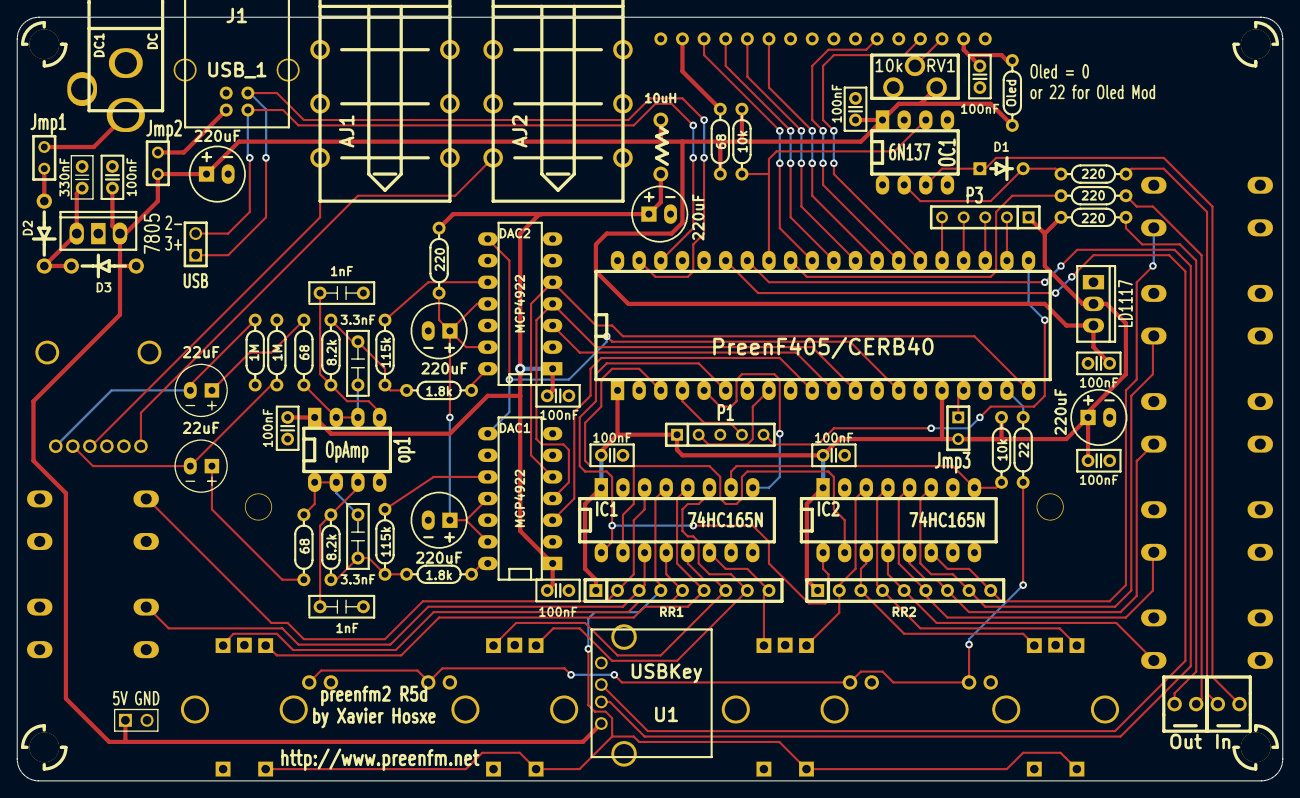
[picture p31: board PreenFM.kicad_pcb from above]

Board: 2 copper layers, 148.6 x 89.7 mm, 92 parts (0 on the bottom side), 80 nets.
