sebiik/axoloti-preenfm2/preenfm2-master/hardware/preenF405/Preen40/Preen40.kicad_pcb

## KiCad design preenfm2-master/hardware/preenF405/Preen40/Preen40.kicad_pcb (2019-06-26)

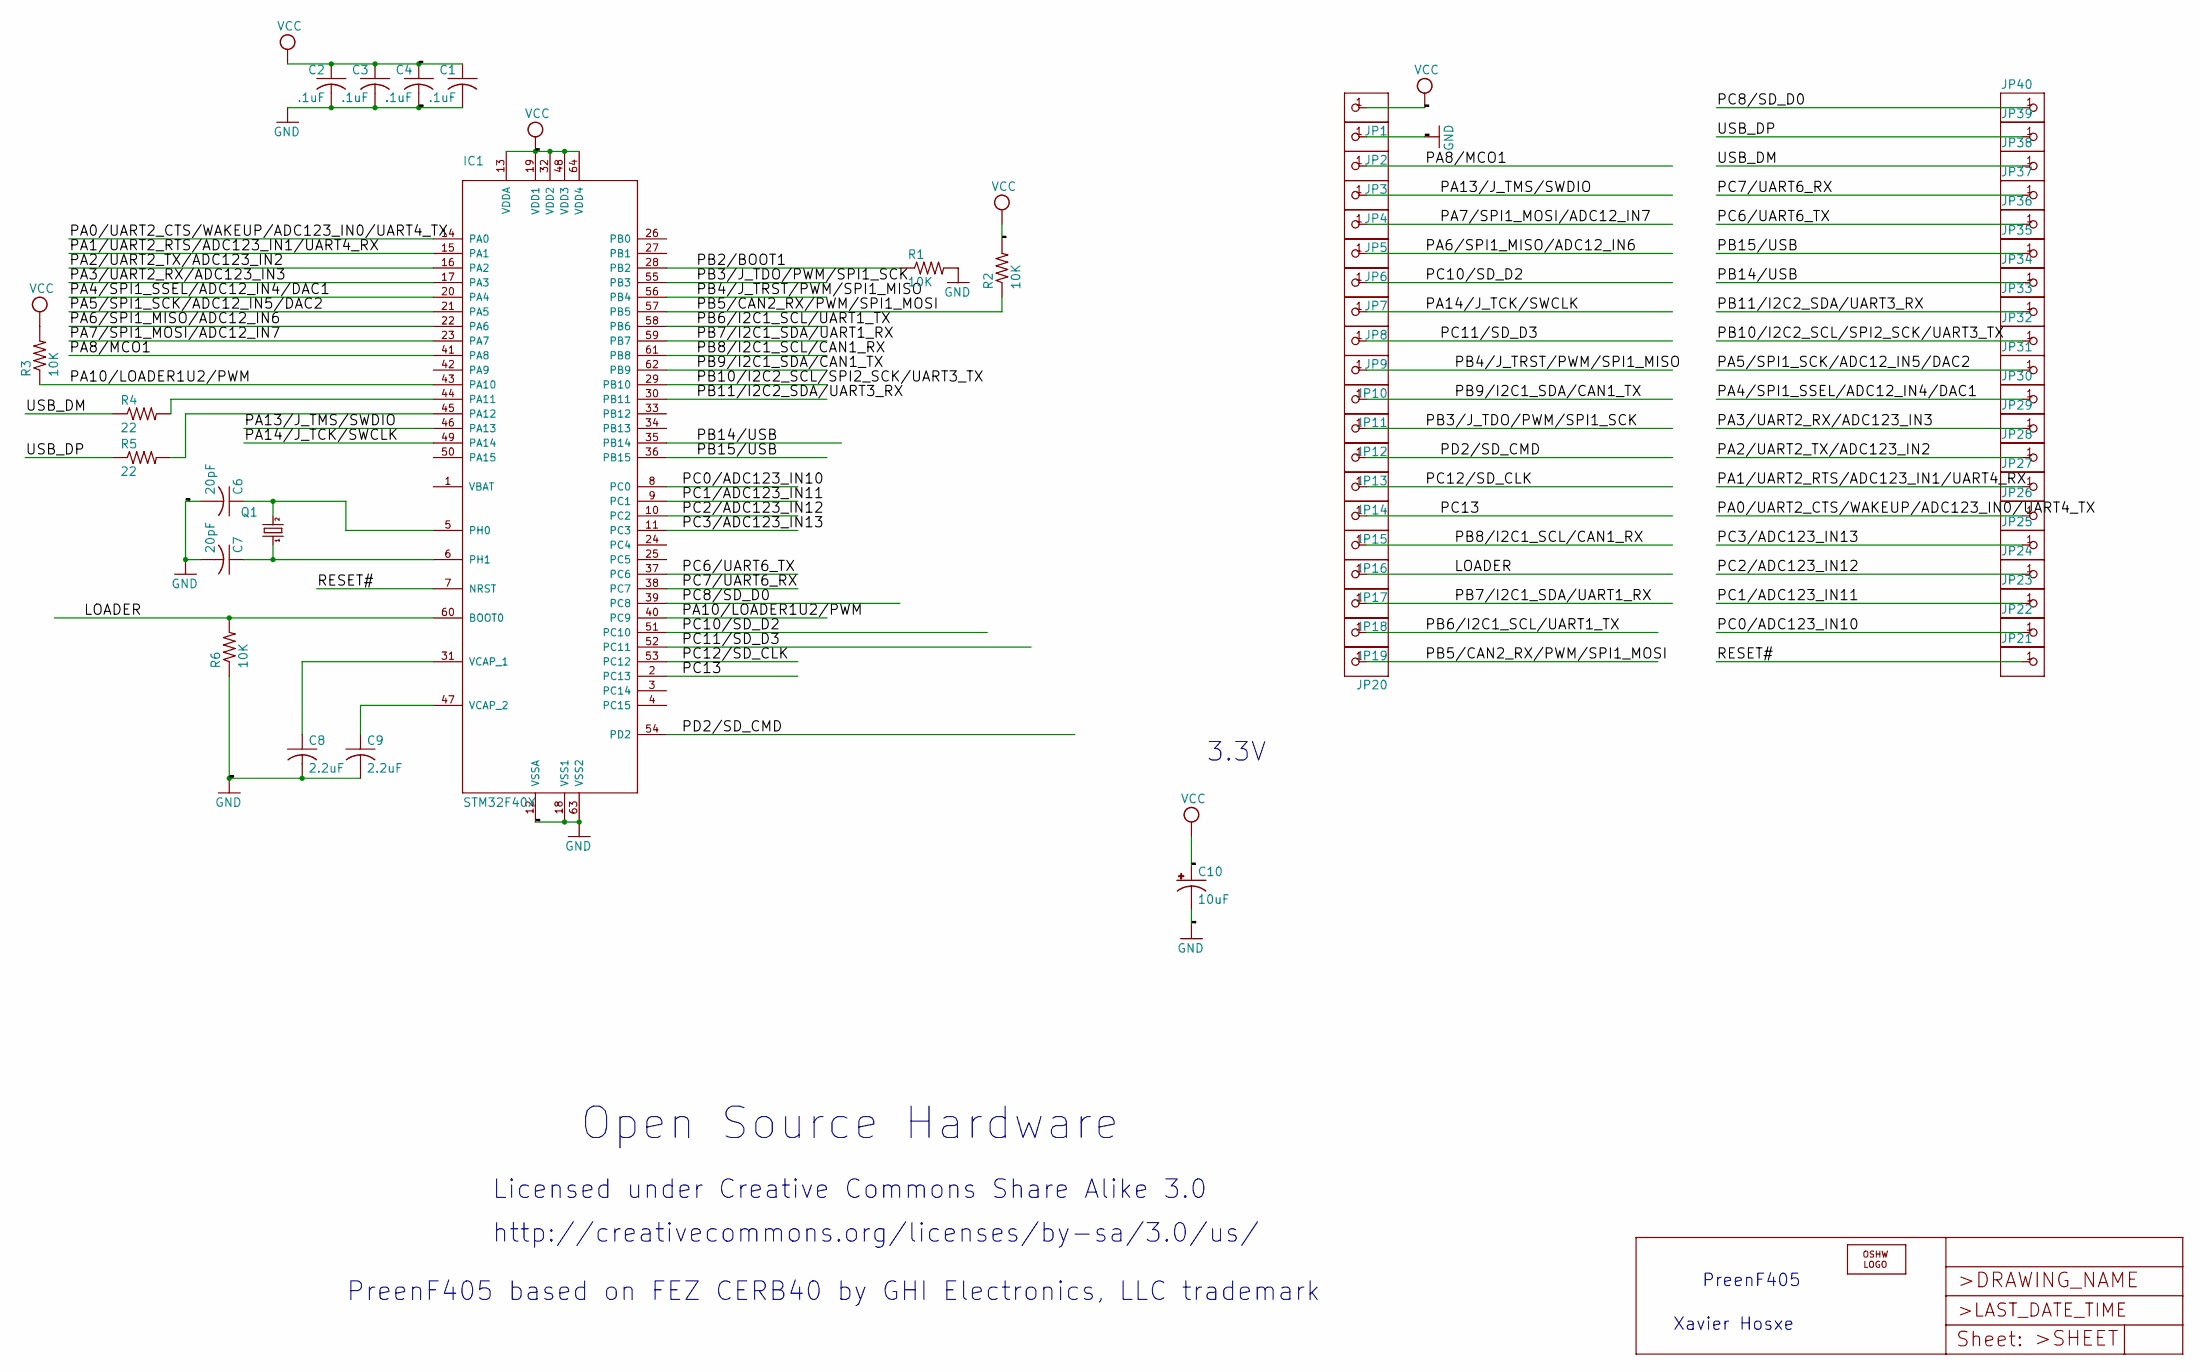
[picture p32: schematic Preen40.sch]

Parts:
C1, C2, C3, C4: .1uF; C0603K
C6, C7: 20pF; C0603K
C8, C9: 2.2uF; C0805K
C10: 10uF; CT3528
IC1: STM32F40X; LQFP64
JP1, JP2, JP3, JP4, JP5, JP6, JP7, JP8, JP9, JP10, JP11, JP12, JP13, JP14, JP15, JP16, JP17, JP18, JP19, JP20, JP21, JP22, JP23, JP24, JP25, JP26, JP27, JP28, JP29, JP30, JP31, JP32, JP33, JP34, JP35, JP36, JP37, JP38, JP39, JP40: PINHD-1X1; 1X01
LOGO1: LOGO-OSHW-FILLX0200-NT; OSHW_FILLX200_NOTEXT
Q1: 12Mhz; SM49@1
R1, R2, R3, R6: 10K; R0603
R4, R5: 22; R0603

Connections:
/LOADER: IC1.60 (BOOT0), JP17.1, R6.2
/PA0/UART2_CTS/WAKEUP/ADC123_IN0/UART4_TX: IC1.14 (PA0), JP26.1
/PA1/UART2_RTS/ADC123_IN1/UART4_RX: IC1.15 (PA1), JP27.1
/PA2/UART2_TX/ADC123_IN2: IC1.16 (PA2), JP28.1
/PA3/UART2_RX/ADC123_IN3: IC1.17 (PA3), JP29.1
/PA4/SPI1_SSEL/ADC12_IN4/DAC1: IC1.20 (PA4), JP30.1
/PA5/SPI1_SCK/ADC12_IN5/DAC2: IC1.21 (PA5), JP31.1
/PA6/SPI1_MISO/ADC12_IN6: IC1.22 (PA6), JP6.1
/PA7/SPI1_MOSI/ADC12_IN7: IC1.23 (PA7), JP5.1
/PA8/MCO1: IC1.41 (PA8), JP3.1
/PA10/LOADER1U2/PWM: IC1.40 (PC9), IC1.43 (PA10), R3.1
/PA13/J_TMS/SWDIO: IC1.46 (PA13), JP4.1
/PA14/J_TCK/SWCLK: IC1.49 (PA14), JP8.1
/PB2/BOOT1: IC1.28 (PB2), R1.1
/PB3/J_TDO/PWM/SPI1_SCK: IC1.55 (PB3), JP12.1
/PB4/J_TRST/PWM/SPI1_MISO: IC1.56 (PB4), JP10.1
/PB5/CAN2_RX/PWM/SPI1_MOSI: IC1.57 (PB5), JP20.1, R2.1
/PB6/I2C1_SCL/UART1_TX: IC1.58 (PB6), JP19.1
/PB7/I2C1_SDA/UART1_RX: IC1.59 (PB7), JP18.1
/PB8/I2C1_SCL/CAN1_RX: IC1.61 (PB8), JP16.1
/PB9/I2C1_SDA/CAN1_TX: IC1.62 (PB9), JP11.1
/PB10/I2C2_SCL/SPI2_SCK/UART3_TX: IC1.29 (PB10), JP32.1
/PB11/I2C2_SDA/UART3_RX: IC1.30 (PB11), JP33.1
/PB14/USB: IC1.35 (PB14), JP34.1
/PB15/USB: IC1.36 (PB15), JP35.1
/PC0/ADC123_IN10: IC1.8 (PC0), JP22.1
/PC1/ADC123_IN11: IC1.9 (PC1), JP23.1
/PC2/ADC123_IN12: IC1.10 (PC2), JP24.1
/PC3/ADC123_IN13: IC1.11 (PC3), JP25.1
/PC6/UART6_TX: IC1.37 (PC6), JP36.1
/PC7/UART6_RX: IC1.38 (PC7), JP37.1
/PC8/SD_D0: IC1.39 (PC8), JP40.1
/PC10/SD_D2: IC1.51 (PC10), JP7.1
/PC11/SD_D3: IC1.52 (PC11), JP9.1
/PC12/SD_CLK: IC1.53 (PC12), JP14.1
/PC13: IC1.2 (PC13), JP15.1
/PD2/SD_CMD: IC1.54 (PD2), JP13.1
/RESET#: IC1.7 (NRST), JP21.1
/USB_DM: JP38.1, R4.1
/USB_DP: JP39.1, R5.1
GND: C1.2, C2.2, C3.2, C4.2, C6.2, C7.2, C8.2, C9.2, C10.-, IC1.12 (VSSA), IC1.18 (VSS1), IC1.63 (VSS2), JP2.1, R1.2, R6.1
unnamed: C6.1, IC1.5 (PH0), Q1.2
unnamed: C7.1, IC1.6 (PH1), Q1.1
unnamed: C8.1, IC1.31 (VCAP_1)
unnamed: C9.1, IC1.47 (VCAP_2)
unnamed: IC1.44 (PA11), R4.2
unnamed: IC1.45 (PA12), R5.2
VCC: C1.1, C2.1, C3.1, C4.1, C10.+, IC1.13 (VDDA), IC1.19 (VDD1), IC1.32 (VDD2), IC1.48 (VDD3), IC1.64 (VDD4), JP1.1, R2.2, R3.2

Notes on the sheet:
PreenF405
Xavier Hosxe
Open Source Hardware
Licensed under Creative Commons Share Alike 3.0
PreenF405 based on FEZ CERB40 by GHI Electronics, LLC trademark
http://creativecommons.org/licenses/by-sa/3.0/us/
3.3V

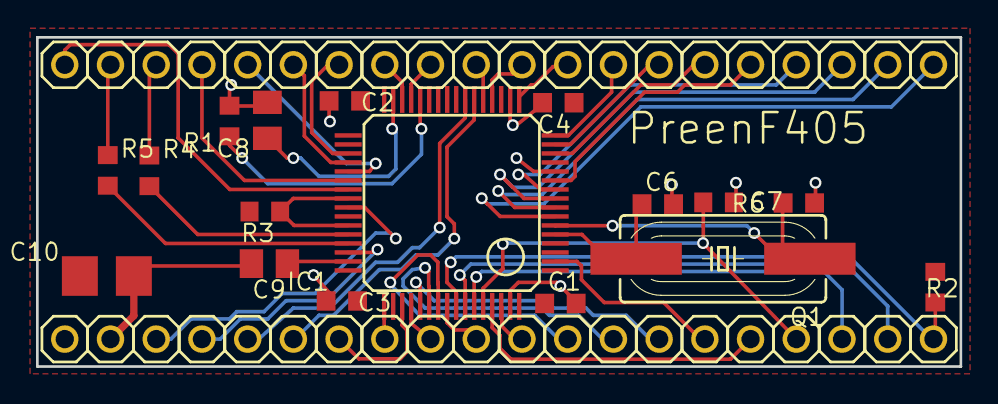
[picture p33: board Preen40.kicad_pcb from above]

Board: 2 copper layers, 51.3 x 18.3 mm, 58 parts (0 on the bottom side), 48 nets.
