sebiik/axoloti-preenfm2/firmware/board_preenfm2.h

/**
 * Copyright (C) 2013, 2014 Johannes Taelman
 * Copyright (C) 2016 Ricard Wanderlof
 *
 * This file is part of Axoloti.
 *
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
 * You should have received a copy of the GNU General Public License along with
 * Axoloti. If not, see <http://www.gnu.org/licenses/>.
 */
#ifndef _BOARD_H_
#define _BOARD_H_

/* Board definitions for Audiothingies P6 */

/*
 * Board oscillators-related settings.
 * NOTE: LSE not fitted.
 */
#if !defined(STM32_LSECLK)
#define STM32_LSECLK                0
#endif

#if !defined(STM32_HSECLK)
#define STM32_HSECLK                12000000
#endif

/*
 * Board voltages.
 * Required for performance limits calculation.
 */
#define STM32_VDD                   300

/*
 * MCU type as defined in the ST header.
 */
#define STM32F40_41xxx

/*
 * IO pins assignments.
 */
/*
 * I/O ports initial setup, this configuration is established soon after reset
 * in the initialization code.
 * Please refer to the STM32 Reference Manual for details.
 */
#define PIN_MODE_INPUT(n)           (0U << ((n) * 2))
#define PIN_MODE_OUTPUT(n)          (1U << ((n) * 2))
#define PIN_MODE_ALTERNATE(n)       (2U << ((n) * 2))
#define PIN_MODE_ANALOG(n)          (3U << ((n) * 2))
#define PIN_ODR_LOW(n)              (0U << (n))
#define PIN_ODR_HIGH(n)             (1U << (n))
#define PIN_OTYPE_PUSHPULL(n)       (0U << (n))
#define PIN_OTYPE_OPENDRAIN(n)      (1U << (n))
#define PIN_OSPEED_2M(n)            (0U << ((n) * 2))
#define PIN_OSPEED_25M(n)           (1U << ((n) * 2))
#define PIN_OSPEED_50M(n)           (2U << ((n) * 2))
#define PIN_OSPEED_100M(n)          (3U << ((n) * 2))
#define PIN_PUPDR_FLOATING(n)       (0U << ((n) * 2))
#define PIN_PUPDR_PULLUP(n)         (1U << ((n) * 2))
#define PIN_PUPDR_PULLDOWN(n)       (2U << ((n) * 2))
#define PIN_AFIO_AF(n, v)           ((v##U) << ((n % 8) * 4))

/*
 * GPIOA setup:
 */
#define GPIOA_DIN_DATA              0 /* input floating */
#define GPIOA_DIN_CLK               1 /* output pushpull maximum */
#define GPIOA_DIN_INH               2 /* output pushpull maximum */
#define GPIOA_DIN_LATCH             3 /* output pushpull maximum */
#define GPIOA_I2S_WS                4 /* alternate 6 - I2S3 */
#define GPIOA_DOUT_OE               5 /* output pushpull maximum */
#define GPIOA_DOUT_DATA             6 /* output pushpull maximum */
#define GPIOA_DOUT_CLK              7 /* output pushpull maximum */
#define GPIOA_DOUT_LATCH            8 /* output pushpull maximum */
#define GPIOA_VBUS_FS               9 /* n/a - input floating */
#define GPIOA_OTG_FS_ID             10 /* alternate 10 */
#define GPIOA_OTG_FS_DM             11 /* alternate 10 - USB + */
#define GPIOA_OTG_FS_DP             12 /* alternate 10 - USB - */
#define GPIOA_SWDIO                 13 /* n/c - input pullup or alternate 0 */
#define GPIOA_SWCLK                 14 /* n/c - input pullup or alternate 0 */
#define GPIOA_PIN15                 15 /* n/a - input pullup */

/* Axoloti Core assignments:
 * PA0  - BUTTON                    (input floating).
 * PA1  - PIN1                      (input pullup).
 * PA2  - PIN2                      (input pullup).
 * PA3  - PIN3                      (input pullup).
 * PA4  - LRCK                      (alternate 6).
 * PA5  - SPC                       (alternate 5).
 * PA6  - SDO                       (alternate 5).
 * PA7  - SDI                       (alternate 5).
 * PA8  - PIN8                      (input pullup).
 * PA9  - VBUS_FS                   (input floating).
 * PA10 - OTG_FS_ID                 (alternate 10).
 * PA11 - OTG_FS_DM                 (alternate 10).
 * PA12 - OTG_FS_DP                 (alternate 10).
 * PA13 - SWDIO                     (alternate 0).
 * PA14 - SWCLK                     (alternate 0).
 * PA15 - PIN15                     (input pullup).
 */
#define VAL_GPIOA_MODER             (PIN_MODE_INPUT(GPIOA_DIN_DATA) |       \
                                     PIN_MODE_OUTPUT(GPIOA_DIN_CLK) |       \
                                     PIN_MODE_OUTPUT(GPIOA_DIN_INH) |       \
                                     PIN_MODE_OUTPUT(GPIOA_DIN_LATCH) |     \
                                     PIN_MODE_ALTERNATE(GPIOA_I2S_WS) |     \
                                     PIN_MODE_OUTPUT(GPIOA_DOUT_OE) |       \
                                     PIN_MODE_OUTPUT(GPIOA_DOUT_DATA) |     \
                                     PIN_MODE_OUTPUT(GPIOA_DOUT_CLK) |      \
                                     PIN_MODE_OUTPUT(GPIOA_DOUT_LATCH) |    \
                                     PIN_MODE_INPUT(GPIOA_VBUS_FS) |        \
                                     PIN_MODE_ALTERNATE(GPIOA_OTG_FS_ID) |  \
                                     PIN_MODE_ALTERNATE(GPIOA_OTG_FS_DM) |  \
                                     PIN_MODE_ALTERNATE(GPIOA_OTG_FS_DP) |  \
                                     PIN_MODE_ALTERNATE(GPIOA_SWDIO) |      \
                                     PIN_MODE_ALTERNATE(GPIOA_SWCLK) |      \
                                     PIN_MODE_INPUT(GPIOA_PIN15))
#define VAL_GPIOA_OTYPER            (PIN_OTYPE_PUSHPULL(GPIOA_DIN_DATA) |   \
                                     PIN_OTYPE_PUSHPULL(GPIOA_DIN_CLK) |    \
                                     PIN_OTYPE_PUSHPULL(GPIOA_DIN_INH) |    \
                                     PIN_OTYPE_PUSHPULL(GPIOA_DIN_LATCH) |  \
                                     PIN_OTYPE_PUSHPULL(GPIOA_I2S_WS) |     \
                                     PIN_OTYPE_PUSHPULL(GPIOA_DOUT_OE) |    \
                                     PIN_OTYPE_PUSHPULL(GPIOA_DOUT_DATA) |  \
                                     PIN_OTYPE_PUSHPULL(GPIOA_DOUT_CLK) |   \
                                     PIN_OTYPE_PUSHPULL(GPIOA_DOUT_LATCH) | \
                                     PIN_OTYPE_PUSHPULL(GPIOA_VBUS_FS) |    \
                                     PIN_OTYPE_PUSHPULL(GPIOA_OTG_FS_ID) |  \
                                     PIN_OTYPE_PUSHPULL(GPIOA_OTG_FS_DM) |  \
                                     PIN_OTYPE_PUSHPULL(GPIOA_OTG_FS_DP) |  \
                                     PIN_OTYPE_PUSHPULL(GPIOA_SWDIO) |      \
                                     PIN_OTYPE_PUSHPULL(GPIOA_SWCLK) |      \
                                     PIN_OTYPE_PUSHPULL(GPIOA_PIN15))
#define VAL_GPIOA_OSPEEDR           (PIN_OSPEED_50M(GPIOA_DIN_DATA) |       \
                                     PIN_OSPEED_50M(GPIOA_DIN_CLK) |        \
                                     PIN_OSPEED_50M(GPIOA_DIN_INH) |        \
                                     PIN_OSPEED_50M(GPIOA_DIN_LATCH) |      \
                                     PIN_OSPEED_100M(GPIOA_I2S_WS) |        \
                                     PIN_OSPEED_50M(GPIOA_DOUT_OE) |        \
                                     PIN_OSPEED_50M(GPIOA_DOUT_DATA) |      \
                                     PIN_OSPEED_50M(GPIOA_DOUT_CLK) |       \
                                     PIN_OSPEED_50M(GPIOA_DOUT_LATCH) |     \
                                     PIN_OSPEED_100M(GPIOA_VBUS_FS) |       \
                                     PIN_OSPEED_100M(GPIOA_OTG_FS_ID) |     \
                                     PIN_OSPEED_100M(GPIOA_OTG_FS_DM) |     \
                                     PIN_OSPEED_100M(GPIOA_OTG_FS_DP) |     \
                                     PIN_OSPEED_100M(GPIOA_SWDIO) |         \
                                     PIN_OSPEED_100M(GPIOA_SWCLK) |         \
                                     PIN_OSPEED_100M(GPIOA_PIN15))
#define VAL_GPIOA_PUPDR             (PIN_PUPDR_FLOATING(GPIOA_DIN_DATA) |   \
                                     PIN_PUPDR_FLOATING(GPIOA_DIN_CLK) |    \
                                     PIN_PUPDR_FLOATING(GPIOA_DIN_INH) |    \
                                     PIN_PUPDR_FLOATING(GPIOA_DIN_LATCH) |  \
                                     PIN_PUPDR_FLOATING(GPIOA_I2S_WS) |     \
                                     PIN_PUPDR_FLOATING(GPIOA_DOUT_OE) |    \
                                     PIN_PUPDR_FLOATING(GPIOA_DOUT_DATA) |  \
                                     PIN_PUPDR_FLOATING(GPIOA_DOUT_CLK) |   \
                                     PIN_PUPDR_FLOATING(GPIOA_DOUT_LATCH) | \
                                     PIN_PUPDR_FLOATING(GPIOA_VBUS_FS) |    \
                                     PIN_PUPDR_FLOATING(GPIOA_OTG_FS_ID) |  \
                                     PIN_PUPDR_FLOATING(GPIOA_OTG_FS_DM) |  \
                                     PIN_PUPDR_FLOATING(GPIOA_OTG_FS_DP) |  \
                                     PIN_PUPDR_FLOATING(GPIOA_SWDIO) |      \
                                     PIN_PUPDR_FLOATING(GPIOA_SWCLK) |      \
                                     PIN_PUPDR_PULLUP(GPIOA_PIN15))
#define VAL_GPIOA_ODR               (PIN_ODR_HIGH(GPIOA_DIN_DATA) |         \
                                     PIN_ODR_HIGH(GPIOA_DIN_CLK) |          \
                                     PIN_ODR_HIGH(GPIOA_DIN_INH) |          \
                                     PIN_ODR_HIGH(GPIOA_DIN_LATCH) |        \
                                     PIN_ODR_HIGH(GPIOA_I2S_WS) |           \
                                     PIN_ODR_HIGH(GPIOA_DOUT_OE) |          \
                                     PIN_ODR_HIGH(GPIOA_DOUT_DATA) |        \
                                     PIN_ODR_HIGH(GPIOA_DOUT_CLK) |         \
                                     PIN_ODR_HIGH(GPIOA_DOUT_LATCH) |       \
                                     PIN_ODR_HIGH(GPIOA_VBUS_FS) |          \
                                     PIN_ODR_HIGH(GPIOA_OTG_FS_ID) |        \
                                     PIN_ODR_HIGH(GPIOA_OTG_FS_DM) |        \
                                     PIN_ODR_HIGH(GPIOA_OTG_FS_DP) |        \
                                     PIN_ODR_HIGH(GPIOA_SWDIO) |            \
                                     PIN_ODR_HIGH(GPIOA_SWCLK) |            \
                                     PIN_ODR_HIGH(GPIOA_PIN15))
#define VAL_GPIOA_AFRL              (PIN_AFIO_AF(GPIOA_DIN_DATA, 0) |       \
                                     PIN_AFIO_AF(GPIOA_DIN_CLK, 0) |        \
                                     PIN_AFIO_AF(GPIOA_DIN_INH, 0) |        \
                                     PIN_AFIO_AF(GPIOA_DIN_LATCH, 0) |      \
                                     PIN_AFIO_AF(GPIOA_I2S_WS, 6) |         \
                                     PIN_AFIO_AF(GPIOA_DOUT_OE, 0) |        \
                                     PIN_AFIO_AF(GPIOA_DOUT_DATA, 0) |      \
                                     PIN_AFIO_AF(GPIOA_DOUT_CLK, 0))
#define VAL_GPIOA_AFRH              (PIN_AFIO_AF(GPIOA_DOUT_LATCH, 0) |     \
                                     PIN_AFIO_AF(GPIOA_VBUS_FS, 0) |        \
                                     PIN_AFIO_AF(GPIOA_OTG_FS_ID, 10) |     \
                                     PIN_AFIO_AF(GPIOA_OTG_FS_DM, 10) |     \
                                     PIN_AFIO_AF(GPIOA_OTG_FS_DP, 10) |     \
                                     PIN_AFIO_AF(GPIOA_SWDIO, 0) |          \
                                     PIN_AFIO_AF(GPIOA_SWCLK, 0) |          \
                                     PIN_AFIO_AF(GPIOA_PIN15, 0))

/*
 * GPIOB setup:
 */
#define GPIOB_PIN0                  0 /* n/a */
#define GPIOB_PIN1                  1 /* n/a */
#define GPIOB_PIN2                  2 /* n/a */
#define GPIOB_I2S_CK                3 /* alternate 6 - I2S3 */
#define GPIOB_PIN4                  4 /* n/c */
#define GPIOB_PIN5                  5 /* n/c */
#define GPIOB_SDL                   6 /* alternate 4 - I2C1 */
#define GPIOB_SDA                   7 /* alternate 4 - I2C1 */
#define GPIOB_PIN8                  8 /* n/c */
#define GPIOB_PIN9                  9 /* n/c */
#define GPIOB_D4                    10 /* LCD D4 - output pushpull maximum */
#define GPIOB_D6                    11 /* LCD D6 - output pushpull maximum */
#define GPIOB_PIN12                 12 /* n/c */
#define GPIOB_PIN13                 13 /* n/a */
#define GPIOB_D5                    14 /* LCD D5 - output pushpull maximum */
#define GPIOB_D7                    15 /* LCD D7 - output pushpull maximum */

/*
 * Axoloti Core GPIOB setup:
 *
 * PB0  - PIN0                      (input pullup).
 * PB1  - PIN1                      (input pullup).
 * PB2  - PIN2                      (input pullup).
 * PB3  - SWO                       (alternate 0).
 * PB4  - PIN4                      (input pullup).
 * PB5  - PIN5                      fmc
 * PB6  - PIN6                      fmc
 * PB7  - PIN7                      (input pullup).
 * PB8  - PIN8                      (input pullup).
 * PB9  - SDA                       (alternate 4).
 * PB10 - CLK_IN                    (input pullup).
 * PB11 - PIN11                     (input pullup).
 * PB12 - PIN12                     (input pullup).
 * PB13 - PIN13                     (input pullup).
 * PB14 - PIN14                     (input pullup).
 * PB15 - PIN15                     (input pullup).
 */
#define VAL_GPIOB_MODER             (PIN_MODE_INPUT(GPIOB_PIN0) |           \
                                     PIN_MODE_INPUT(GPIOB_PIN1) |           \
                                     PIN_MODE_INPUT(GPIOB_PIN2) |           \
                                     PIN_MODE_ALTERNATE(GPIOB_I2S_CK) |     \
                                     PIN_MODE_INPUT(GPIOB_PIN4) |           \
                                     PIN_MODE_INPUT(GPIOB_PIN5) |           \
                                     PIN_MODE_ALTERNATE(GPIOB_SDL) |        \
                                     PIN_MODE_ALTERNATE(GPIOB_SDA) |        \
                                     PIN_MODE_INPUT(GPIOB_PIN8) |           \
                                     PIN_MODE_INPUT(GPIOB_PIN9) |           \
                                     PIN_MODE_OUTPUT(GPIOB_D4) |            \
                                     PIN_MODE_OUTPUT(GPIOB_D6) |            \
                                     PIN_MODE_INPUT(GPIOB_PIN12) |          \
                                     PIN_MODE_INPUT(GPIOB_PIN13) |          \
                                     PIN_MODE_OUTPUT(GPIOB_D5) |            \
                                     PIN_MODE_OUTPUT(GPIOB_D7))
#define VAL_GPIOB_OTYPER            (PIN_OTYPE_PUSHPULL(GPIOB_PIN0) |       \
                                     PIN_OTYPE_PUSHPULL(GPIOB_PIN1) |       \
                                     PIN_OTYPE_PUSHPULL(GPIOB_PIN2) |       \
                                     PIN_OTYPE_PUSHPULL(GPIOB_I2S_CK) |     \
                                     PIN_OTYPE_PUSHPULL(GPIOB_PIN4) |       \
                                     PIN_OTYPE_PUSHPULL(GPIOB_PIN5) |       \
                                     PIN_OTYPE_PUSHPULL(GPIOB_SDL) |        \
                                     PIN_OTYPE_OPENDRAIN(GPIOB_SDA) |       \
                                     PIN_OTYPE_PUSHPULL(GPIOB_PIN8) |       \
                                     PIN_OTYPE_PUSHPULL(GPIOB_PIN9) |       \
                                     PIN_OTYPE_PUSHPULL(GPIOB_D4) |         \
                                     PIN_OTYPE_PUSHPULL(GPIOB_D6) |         \
                                     PIN_OTYPE_PUSHPULL(GPIOB_PIN12) |      \
                                     PIN_OTYPE_PUSHPULL(GPIOB_PIN13) |      \
                                     PIN_OTYPE_PUSHPULL(GPIOB_D5) |         \
                                     PIN_OTYPE_PUSHPULL(GPIOB_D7))
#define VAL_GPIOB_OSPEEDR           (PIN_OSPEED_100M(GPIOB_PIN0) |          \
                                     PIN_OSPEED_100M(GPIOB_PIN1) |          \
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
                                     PIN_AFIO_AF(GPIOB_PIN9, 0) |           \
                                     PIN_AFIO_AF(GPIOB_D4, 0) |             \
                                     PIN_AFIO_AF(GPIOB_D6, 0) |             \
                                     PIN_AFIO_AF(GPIOB_PIN12, 0) |          \
                                     PIN_AFIO_AF(GPIOB_PIN13, 0) |          \
                                     PIN_AFIO_AF(GPIOB_D5, 0) |             \
                                     PIN_AFIO_AF(GPIOB_D7, 0))

/*
 * GPIOC setup:
 */
#define GPIOC_RS                    0 /* LCD RS - output pushpull maximum */
#define GPIOC_E                     1 /* LCD DE - output pushpull maximum */
#define GPIOC_LED1                  2 /* LED1 - output pushpull maximum */
#define GPIOC_PIN3                  3 /* n/c */
#define GPIOC_PIN4                  4 /* n/a */
#define GPIOC_PIN5                  5 /* n/a */
#define GPIOC_S1                    6 /* S1 - input pullup */
#define GPIOC_I2S_MCK               7 /* alternate 6 - I2S3 */
#define GPIOC_S4                    8 /* S4 - input pullup */
#define GPIOC_S7                    9 /* S7 - input pullup */
#define GPIOC_MIDI_OUT              10 /* alternate 7 - USART3 TX */
#define GPIOC_MIDI_IN               11 /* alternate 7 - USART3 RX */
#define GPIOC_I2S_SD                12 /* alternate 6 - I2S3 */
#define GPIOC_PIN13                 13 /* n/a */
#define GPIOC_PIN14                 14 /* n/a */
#define GPIOC_PIN15                 15 /* n/a */

/*
 * GPIOC setup:
 *
 * PC0  - PIN0                      fmc
 * PC1  - PIN1                      (input pullup).
 * PC2  - PIN2                      fmc
 * PC3  - PIN3                      fmc
 * PC4  - PIN4                      (input pullup).
 * PC5  - PIN5                      (input pullup).
 * PC6  - PIN6                      (input pullup).
 * PC7  - MCLK                      (alternate 6).
 * PC8  - PIN8                      (input pullup).
 * PC9  - PIN9                      (input pullup).
 * PC10 - SCLK                      (alternate 6).
 * PC11 - PIN11                     (input pullup).
 * PC12 - SDIN                      (alternate 6).
 * PC13 - PIN13                     (input pullup).
 * PC14 - PIN14                     (input pullup).
 * PC15 - PIN15                     (input pullup).
 */
 #define VAL_GPIOC_MODER             (PIN_MODE_ALTERNATE(GPIOC_RS) |       \
                                      PIN_MODE_INPUT(GPIOC_E) |           \
                                     PIN_MODE_OUTPUT(GPIOC_LED1) |          \
                                     PIN_MODE_INPUT(GPIOC_PIN3) |           \
                                     PIN_MODE_INPUT(GPIOC_PIN4) |           \
                                     PIN_MODE_INPUT(GPIOC_PIN5) |           \
                                     PIN_MODE_INPUT(GPIOC_S1) |             \
                                     PIN_MODE_ALTERNATE(GPIOC_I2S_MCK) |    \
                                     PIN_MODE_INPUT(GPIOC_S4) |             \
                                     PIN_MODE_INPUT(GPIOC_S7) |             \
                                     PIN_MODE_ALTERNATE(GPIOC_MIDI_OUT) |   \
                                     PIN_MODE_ALTERNATE(GPIOC_MIDI_IN) |    \
                                     PIN_MODE_ALTERNATE(GPIOC_I2S_SD) |     \
                                     PIN_MODE_INPUT(GPIOC_PIN13) |          \
                                     PIN_MODE_INPUT(GPIOC_PIN14) |          \
                                     PIN_MODE_INPUT(GPIOC_PIN15))
#define VAL_GPIOC_OTYPER            (PIN_OTYPE_PUSHPULL(GPIOC_RS) |         \
                                     PIN_OTYPE_PUSHPULL(GPIOC_E) |          \
                                     PIN_OTYPE_PUSHPULL(GPIOC_LED1) |       \
                                     PIN_OTYPE_PUSHPULL(GPIOC_PIN3) |       \
                                     PIN_OTYPE_PUSHPULL(GPIOC_PIN4) |       \
                                     PIN_OTYPE_PUSHPULL(GPIOC_PIN5) |       \
                                     PIN_OTYPE_PUSHPULL(GPIOC_S1) |         \
                                     PIN_OTYPE_PUSHPULL(GPIOC_I2S_MCK) |    \
                                     PIN_OTYPE_PUSHPULL(GPIOC_S4) |         \
                                     PIN_OTYPE_PUSHPULL(GPIOC_S7) |         \
                                     PIN_OTYPE_PUSHPULL(GPIOC_MIDI_OUT) |   \
                                     PIN_OTYPE_PUSHPULL(GPIOC_MIDI_IN) |    \
                                     PIN_OTYPE_PUSHPULL(GPIOC_I2S_SD) |     \
                                     PIN_OTYPE_PUSHPULL(GPIOC_PIN13) |      \
                                     PIN_OTYPE_PUSHPULL(GPIOC_PIN14) |      \
                                     PIN_OTYPE_PUSHPULL(GPIOC_PIN15))
#define VAL_GPIOC_OSPEEDR           (PIN_OSPEED_50M(GPIOC_RS) |             \
                                     PIN_OSPEED_50M(GPIOC_E) |              \
                                     PIN_OSPEED_50M(GPIOC_LED1) |           \
                                     PIN_OSPEED_50M(GPIOC_PIN3) |           \
                                     PIN_OSPEED_50M(GPIOC_PIN4) |           \
                                     PIN_OSPEED_50M(GPIOC_PIN5) |           \
                                     PIN_OSPEED_50M(GPIOC_S1) |             \
                                     PIN_OSPEED_100M(GPIOC_I2S_MCK) |       \
                                     PIN_OSPEED_50M(GPIOC_S4) |             \
                                     PIN_OSPEED_50M(GPIOC_S7) |             \
                                     PIN_OSPEED_100M(GPIOC_MIDI_OUT) |      \
                                     PIN_OSPEED_100M(GPIOC_MIDI_IN) |       \
                                     PIN_OSPEED_100M(GPIOC_I2S_SD) |        \
                                     PIN_OSPEED_50M(GPIOC_PIN13) |          \
                                     PIN_OSPEED_50M(GPIOC_PIN14) |          \
                                     PIN_OSPEED_50M(GPIOC_PIN15))
#define VAL_GPIOC_PUPDR             (PIN_PUPDR_FLOATING(GPIOC_RS) |         \
                                     PIN_PUPDR_FLOATING(GPIOC_E) |          \
                                     PIN_PUPDR_FLOATING(GPIOC_LED1) |       \
                                     PIN_PUPDR_PULLUP(GPIOC_PIN3) |         \
                                     PIN_PUPDR_PULLUP(GPIOC_PIN4) |         \
                                     PIN_PUPDR_PULLUP(GPIOC_PIN5) |         \
                                     PIN_PUPDR_PULLDOWN(GPIOC_S1) |         \
                                     PIN_PUPDR_FLOATING(GPIOC_I2S_MCK) |    \
                                     PIN_PUPDR_PULLDOWN(GPIOC_S4) |         \
                                     PIN_PUPDR_PULLDOWN(GPIOC_S7) |         \
                                     PIN_PUPDR_FLOATING(GPIOC_MIDI_OUT) |   \
                                     PIN_PUPDR_FLOATING(GPIOC_MIDI_IN) |    \
                                     PIN_PUPDR_FLOATING(GPIOC_I2S_SD) |     \
                                     PIN_PUPDR_PULLUP(GPIOC_PIN13) |        \
                                     PIN_PUPDR_PULLUP(GPIOC_PIN14) |        \
                                     PIN_PUPDR_PULLUP(GPIOC_PIN15))
#define VAL_GPIOC_ODR               (PIN_ODR_HIGH(GPIOC_RS) |               \
                                     PIN_ODR_HIGH(GPIOC_E) |                \
                                     PIN_ODR_HIGH(GPIOC_LED1) |             \
                                     PIN_ODR_HIGH(GPIOC_PIN3) |             \
                                     PIN_ODR_HIGH(GPIOC_PIN4) |             \
                                     PIN_ODR_HIGH(GPIOC_PIN5) |             \
                                     PIN_ODR_HIGH(GPIOC_S1) |               \
                                     PIN_ODR_HIGH(GPIOC_I2S_MCK) |          \
                                     PIN_ODR_HIGH(GPIOC_S4) |               \
                                     PIN_ODR_HIGH(GPIOC_S7) |               \
                                     PIN_ODR_HIGH(GPIOC_MIDI_OUT) |             \
                                     PIN_ODR_HIGH(GPIOC_MIDI_IN) |          \
                                     PIN_ODR_HIGH(GPIOC_I2S_SD) |           \
                                     PIN_ODR_HIGH(GPIOC_PIN13) |            \
                                     PIN_ODR_HIGH(GPIOC_PIN14) |            \
                                     PIN_ODR_HIGH(GPIOC_PIN15))
#define VAL_GPIOC_AFRL              (PIN_AFIO_AF(GPIOC_RS, 0) |             \
                                     PIN_AFIO_AF(GPIOC_E, 0) |              \
                                     PIN_AFIO_AF(GPIOC_LED1, 0) |           \
                                     PIN_AFIO_AF(GPIOC_PIN3, 0) |           \
                                     PIN_AFIO_AF(GPIOC_PIN4, 0) |           \
                                     PIN_AFIO_AF(GPIOC_PIN5, 0) |           \
                                     PIN_AFIO_AF(GPIOC_S1, 0) |             \
                                     PIN_AFIO_AF(GPIOC_I2S_MCK, 6))
#define VAL_GPIOC_AFRH              (PIN_AFIO_AF(GPIOC_S4, 0) |             \
                                     PIN_AFIO_AF(GPIOC_S7, 0) |             \
                                     PIN_AFIO_AF(GPIOC_MIDI_OUT, 7) |       \
                                     PIN_AFIO_AF(GPIOC_MIDI_IN, 7) |        \
                                     PIN_AFIO_AF(GPIOC_I2S_SD, 6) |         \
                                     PIN_AFIO_AF(GPIOC_PIN13, 0) |          \
                                     PIN_AFIO_AF(GPIOC_PIN14, 0) |          \
                                     PIN_AFIO_AF(GPIOC_PIN15, 0))

/*
 * GPIOD setup: - not connected in P6, so keep same pin names for now
 */
#define GPIOD_PIN0                  0
#define GPIOD_PIN1                  1
#define GPIOD_PIN2                  2
#define GPIOD_PIN3                  3
#define GPIOD_RESET                 4
#define GPIOD_OVER_CURRENT          5
#define GPIOD_PIN6                  6
#define GPIOD_PIN7                  7
#define GPIOD_PIN8                  8
#define GPIOD_PIN9                  9
#define GPIOD_PIN10                 10
#define GPIOD_PIN11                 11
#define GPIOD_LED4                  12
#define GPIOD_LED3                  13
#define GPIOD_PIN14                 14
#define GPIOD_PIN15                 15
/*
 * Axoloti Core GPIOB setup:
 *
 * PD0  - PIN0                      fmc
 * PD1  - PIN1                      fmc
 * PD2  - PIN2                      (input pullup).
 * PD3  - PIN3                      (input pullup).
 * PD4  - RESET                     (output pushpull maximum).
 * PD5  - OVER_CURRENT              (input floating).
 * PD6  - PIN6                      (input pullup).
 * PD7  - PIN7                      (input pullup).
 * PD8  - PIN8                      fmc
 * PD9  - PIN9                      fmc
 * PD10 - PIN10                     fmc
 * PD11 - PIN11                     (input pullup).
 * PD12 - LED4                      (output pushpull maximum).
 * PD13 - LED3                      (output pushpull maximum).
 * PD14 - PIN14                     fmc
 * PD15 - PIN15                     fmc
 */
#define VAL_GPIOD_MODER             (PIN_MODE_INPUT(GPIOD_PIN0) |       \
                                     PIN_MODE_INPUT(GPIOD_PIN1) |       \
                                     PIN_MODE_INPUT(GPIOD_PIN2) |           \
                                     PIN_MODE_INPUT(GPIOD_PIN3) |           \
                                     PIN_MODE_INPUT(GPIOD_RESET) |         \
                                     PIN_MODE_INPUT(GPIOD_OVER_CURRENT) |   \
                                     PIN_MODE_INPUT(GPIOD_PIN6) |           \
                                     PIN_MODE_INPUT(GPIOD_PIN7) |           \
                                     PIN_MODE_INPUT(GPIOD_PIN8) |       \
                                     PIN_MODE_INPUT(GPIOD_PIN9) |       \
                                     PIN_MODE_INPUT(GPIOD_PIN10) |      \
                                     PIN_MODE_INPUT(GPIOD_PIN11) |          \
                                     PIN_MODE_OUTPUT(GPIOD_LED4) |          \
                                     PIN_MODE_OUTPUT(GPIOD_LED3) |          \
                                     PIN_MODE_INPUT(GPIOD_PIN14) |      \
                                     PIN_MODE_INPUT(GPIOD_PIN15))
#define VAL_GPIOD_OTYPER            (PIN_OTYPE_PUSHPULL(GPIOD_PIN0) |       \
                                     PIN_OTYPE_PUSHPULL(GPIOD_PIN1) |       \
                                     PIN_OTYPE_PUSHPULL(GPIOD_PIN2) |       \
                                     PIN_OTYPE_PUSHPULL(GPIOD_PIN3) |       \
                                     PIN_OTYPE_PUSHPULL(GPIOD_RESET) |      \
                                     PIN_OTYPE_PUSHPULL(GPIOD_OVER_CURRENT) |\
                                     PIN_OTYPE_PUSHPULL(GPIOD_PIN6) |       \
                                     PIN_OTYPE_PUSHPULL(GPIOD_PIN7) |       \
                                     PIN_OTYPE_PUSHPULL(GPIOD_PIN8) |       \
                                     PIN_OTYPE_PUSHPULL(GPIOD_PIN9) |       \
                                     PIN_OTYPE_PUSHPULL(GPIOD_PIN10) |      \
                                     PIN_OTYPE_PUSHPULL(GPIOD_PIN11) |      \
                                     PIN_OTYPE_PUSHPULL(GPIOD_LED4) |       \
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
                                     PIN_AFIO_AF(GPIOD_PIN3, 0) |           \
                                     PIN_AFIO_AF(GPIOD_RESET, 0) |          \
                                     PIN_AFIO_AF(GPIOD_OVER_CURRENT, 0) |   \
                                     PIN_AFIO_AF(GPIOD_PIN6, 0) |           \
                                     PIN_AFIO_AF(GPIOD_PIN7, 0))
#define VAL_GPIOD_AFRH              (PIN_AFIO_AF(GPIOD_PIN8, 0) |           \
                                     PIN_AFIO_AF(GPIOD_PIN9, 0) |           \
                                     PIN_AFIO_AF(GPIOD_PIN10, 0) |          \
                                     PIN_AFIO_AF(GPIOD_PIN11, 0) |          \
                                     PIN_AFIO_AF(GPIOD_LED4, 0) |           \
                                     PIN_AFIO_AF(GPIOD_LED3, 0) |           \
                                     PIN_AFIO_AF(GPIOD_PIN14, 0) |          \
                                     PIN_AFIO_AF(GPIOD_PIN15, 0))

/*
 * GPIOE setup: - not connected in P6, so keep same pin names for now
 */
#define GPIOE_PIN0                  0
#define GPIOE_PIN1                  1
#define GPIOE_PIN2                  2
#define GPIOE_CS_SPI                3
#define GPIOE_PIN4                  4
#define GPIOE_PIN5                  5
#define GPIOE_PIN6                  6
#define GPIOE_PIN7                  7
#define GPIOE_PIN8                  8
#define GPIOE_PIN9                  9
#define GPIOE_PIN10                 10
#define GPIOE_PIN11                 11
#define GPIOE_PIN12                 12
#define GPIOE_PIN13                 13
#define GPIOE_PIN14                 14
#define GPIOE_PIN15                 15
/*
 * GPIOE setup for Axoloti Core:
 *
 * PE0  - INT1                      fmc
 * PE1  - INT2                      fmc
 * PE2  - PIN2                      (input floating).
 * PE3  - CS_SPI                    (output pushpull maximum).
 * PE4  - PIN4                      (input floating).
 * PE5  - PIN5                      (input floating).
 * PE6  - PIN6                      (input floating).
 * PE7  - PIN7                      fmc
 * PE8  - PIN8                      fmc
 * PE9  - PIN9                      fmc
 * PE10 - PIN10                     fmc
 * PE11 - PIN11                     fmc
 * PE12 - PIN12                     fmc
 * PE13 - PIN13                     fmc
 * PE14 - PIN14                     fmc
 * PE15 - PIN15                     fmc
 */
#define VAL_GPIOE_MODER             (PIN_MODE_INPUT(GPIOE_PIN0) |           \
                                     PIN_MODE_INPUT(GPIOE_PIN1) |           \
                                     PIN_MODE_INPUT(GPIOE_PIN2) |           \
                                     PIN_MODE_INPUT(GPIOE_CS_SPI) |         \
                                     PIN_MODE_INPUT(GPIOE_PIN4) |           \
                                     PIN_MODE_INPUT(GPIOE_PIN5) |           \
                                     PIN_MODE_INPUT(GPIOE_PIN6) |           \
                                     PIN_MODE_INPUT(GPIOE_PIN7) |           \
                                     PIN_MODE_INPUT(GPIOE_PIN8) |           \
                                     PIN_MODE_INPUT(GPIOE_PIN9) |           \
                                     PIN_MODE_INPUT(GPIOE_PIN10) |          \
                                     PIN_MODE_INPUT(GPIOE_PIN11) |          \
                                     PIN_MODE_INPUT(GPIOE_PIN12) |          \
                                     PIN_MODE_INPUT(GPIOE_PIN13) |          \
                                     PIN_MODE_INPUT(GPIOE_PIN14) |          \
                                     PIN_MODE_INPUT(GPIOE_PIN15))
#define VAL_GPIOE_OTYPER            (PIN_OTYPE_PUSHPULL(GPIOE_PIN0) |       \
                                     PIN_OTYPE_PUSHPULL(GPIOE_PIN1) |       \
                                     PIN_OTYPE_PUSHPULL(GPIOE_PIN2) |       \
                                     PIN_OTYPE_PUSHPULL(GPIOE_CS_SPI) |     \
                                     PIN_OTYPE_PUSHPULL(GPIOE_PIN4) |       \
                                     PIN_OTYPE_PUSHPULL(GPIOE_PIN5) |       \
                                     PIN_OTYPE_PUSHPULL(GPIOE_PIN6) |       \
                                     PIN_OTYPE_PUSHPULL(GPIOE_PIN7) |       \
                                     PIN_OTYPE_PUSHPULL(GPIOE_PIN8) |       \
                                     PIN_OTYPE_PUSHPULL(GPIOE_PIN9) |       \
                                     PIN_OTYPE_PUSHPULL(GPIOE_PIN10) |      \
                                     PIN_OTYPE_PUSHPULL(GPIOE_PIN11) |      \
                                     PIN_OTYPE_PUSHPULL(GPIOE_PIN12) |      \
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
                                     PIN_AFIO_AF(GPIOG_PIN2, 0) |           \
                                     PIN_AFIO_AF(GPIOG_PIN3, 0) |           \
                                     PIN_AFIO_AF(GPIOG_PIN4, 0) |           \
                                     PIN_AFIO_AF(GPIOG_PIN5, 0) |           \
                                     PIN_AFIO_AF(GPIOG_PIN6, 0) |           \
                                     PIN_AFIO_AF(GPIOG_PIN7, 0))
#define VAL_GPIOG_AFRH              (PIN_AFIO_AF(GPIOG_PIN8, 0) |           \
                                     PIN_AFIO_AF(GPIOG_PIN9, 0) |           \
                                     PIN_AFIO_AF(GPIOG_PIN10, 0) |          \
                                     PIN_AFIO_AF(GPIOG_PIN11, 0) |          \
                                     PIN_AFIO_AF(GPIOG_PIN12, 0) |          \
                                     PIN_AFIO_AF(GPIOG_PIN13, 0) |          \
                                     PIN_AFIO_AF(GPIOG_PIN14, 0) |          \
                                     PIN_AFIO_AF(GPIOG_PIN15, 0))

/*
 * GPIOH setup: - not connected in P6, so keep same pin names for now
 */
#define GPIOH_OSC_IN                0
#define GPIOH_OSC_OUT               1
#define GPIOH_PIN2                  2
#define GPIOH_PIN3                  3
#define GPIOH_PIN4                  4
#define GPIOH_PIN5                  5
#define GPIOH_PIN6                  6
#define GPIOH_PIN7                  7
#define GPIOH_PIN8                  8
#define GPIOH_PIN9                  9
#define GPIOH_PIN10                 10
#define GPIOH_PIN11                 11
#define GPIOH_PIN12                 12
#define GPIOH_PIN13                 13
#define GPIOH_PIN14                 14
#define GPIOH_PIN15                 15
/*
 * GPIOH setup for Axoloti Core:
 *
 * PH0  - OSC_IN                    (input floating).
 * PH1  - OSC_OUT                   (input floating).
 * PH2  - PIN2                      fmc
 * PH3  - PIN3                      fmc
 * PH4  - PIN4                      (input floating).
 * PH5  - PIN5                      fmc
 * PH6  - PIN6                      fmc
 * PH7  - PIN7                      fmc
 * PH8  - PIN8                      (input floating).
 * PH9  - PIN9                      (input floating).
 * PH10 - PIN10                     (input floating).
 * PH11 - PIN11                     (input floating).
 * PH12 - PIN12                     (input floating).
 * PH13 - PIN13                     (input floating).
 * PH14 - PIN14                     (input floating).
 * PH15 - PIN15                     (input floating).
 */
#define VAL_GPIOH_MODER             (PIN_MODE_INPUT(GPIOH_OSC_IN) |         \
                                     PIN_MODE_INPUT(GPIOH_OSC_OUT) |        \
                                     PIN_MODE_INPUT(GPIOH_PIN2) |           \
                                     PIN_MODE_INPUT(GPIOH_PIN3) |           \
                                     PIN_MODE_INPUT(GPIOH_PIN4) |           \
                                     PIN_MODE_INPUT(GPIOH_PIN5) |           \
                                     PIN_MODE_INPUT(GPIOH_PIN6) |           \
                                     PIN_MODE_INPUT(GPIOH_PIN7) |           \
                                     PIN_MODE_INPUT(GPIOH_PIN8) |           \
                                     PIN_MODE_INPUT(GPIOH_PIN9) |           \
                                     PIN_MODE_INPUT(GPIOH_PIN10) |          \
                                     PIN_MODE_INPUT(GPIOH_PIN11) |          \
                                     PIN_MODE_INPUT(GPIOH_PIN12) |          \
                                     PIN_MODE_INPUT(GPIOH_PIN13) |          \
                                     PIN_MODE_INPUT(GPIOH_PIN14) |          \
                                     PIN_MODE_INPUT(GPIOH_PIN15))
#define VAL_GPIOH_OTYPER            (PIN_OTYPE_PUSHPULL(GPIOH_OSC_IN) |     \
                                     PIN_OTYPE_PUSHPULL(GPIOH_OSC_OUT) |    \
                                     PIN_OTYPE_PUSHPULL(GPIOH_PIN2) |       \
                                     PIN_OTYPE_PUSHPULL(GPIOH_PIN3) |       \
                                     PIN_OTYPE_PUSHPULL(GPIOH_PIN4) |       \
                                     PIN_OTYPE_PUSHPULL(GPIOH_PIN5) |       \
                                     PIN_OTYPE_PUSHPULL(GPIOH_PIN6) |       \
                                     PIN_OTYPE_PUSHPULL(GPIOH_PIN7) |       \
                                     PIN_OTYPE_PUSHPULL(GPIOH_PIN8) |       \
                                     PIN_OTYPE_PUSHPULL(GPIOH_PIN9) |       \
                                     PIN_OTYPE_PUSHPULL(GPIOH_PIN10) |      \
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
                                     PIN_AFIO_AF(GPIOH_OSC_OUT, 0) |        \
                                     PIN_AFIO_AF(GPIOH_PIN2, 0) |           \
                                     PIN_AFIO_AF(GPIOH_PIN3, 0) |           \
                                     PIN_AFIO_AF(GPIOH_PIN4, 0) |           \
                                     PIN_AFIO_AF(GPIOH_PIN5, 0) |           \
                                     PIN_AFIO_AF(GPIOH_PIN6, 0) |           \
                                     PIN_AFIO_AF(GPIOH_PIN7, 0))
#define VAL_GPIOH_AFRH              (PIN_AFIO_AF(GPIOH_PIN8, 0) |           \
                                     PIN_AFIO_AF(GPIOH_PIN9, 0) |           \
                                     PIN_AFIO_AF(GPIOH_PIN10, 0) |          \
                                     PIN_AFIO_AF(GPIOH_PIN11, 0) |          \
                                     PIN_AFIO_AF(GPIOH_PIN12, 0) |          \
                                     PIN_AFIO_AF(GPIOH_PIN13, 0) |          \
                                     PIN_AFIO_AF(GPIOH_PIN14, 0) |          \
                                     PIN_AFIO_AF(GPIOH_PIN15, 0))

#define GPIOI_PIN0                  0
#define GPIOI_PIN1                  1
#define GPIOI_PIN2                  2
#define GPIOI_PIN3                  3
#define GPIOI_PIN4                  4
#define GPIOI_PIN5                  5
#define GPIOI_PIN6                  6
#define GPIOI_PIN7                  7
#define GPIOI_PIN8                  8
#define GPIOI_PIN9                  9
#define GPIOI_PIN10                 10
#define GPIOI_PIN11                 11
#define GPIOI_PIN12                 12
#define GPIOI_PIN13                 13
#define GPIOI_PIN14                 14
#define GPIOI_PIN15                 15

/*
 * GPIOI setup for Axoloti Core:
 *
 * PI0  - PIN0                      (input floating).
 * PI1  - PIN1                      (input floating).
 * PI2  - PIN2                      (input floating).
 * PI3  - PIN3                      (input floating).
 * PI4  - PIN4                      (input floating).
 * PI5  - PIN5                      (input floating).
 * PI6  - PIN6                      (input floating).
 * PI7  - PIN7                      (input floating).
 * PI8  - PIN8                      (input floating).
 * PI9  - PIN9                      (input floating).
 * PI10 - PIN10                     (input floating).
 * PI11 - PIN11                     (input floating).
 * PI12 - PIN12                     (input floating).
 * PI13 - PIN13                     (input floating).
 * PI14 - PIN14                     (input floating).
 * PI15 - PIN15                     (input floating).
 */
#define VAL_GPIOI_MODER             (PIN_MODE_INPUT(GPIOI_PIN0) |           \
                                     PIN_MODE_INPUT(GPIOI_PIN1) |           \
                                     PIN_MODE_INPUT(GPIOI_PIN2) |           \
                                     PIN_MODE_INPUT(GPIOI_PIN3) |           \
                                     PIN_MODE_INPUT(GPIOI_PIN4) |           \
                                     PIN_MODE_INPUT(GPIOI_PIN5) |           \
                                     PIN_MODE_INPUT(GPIOI_PIN6) |           \
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
                                     PIN_PUPDR_FLOATING(GPIOI_PIN13) |      \
                                     PIN_PUPDR_FLOATING(GPIOI_PIN14) |      \
                                     PIN_PUPDR_FLOATING(GPIOI_PIN15))
#define VAL_GPIOI_ODR               (PIN_ODR_HIGH(GPIOI_PIN0) |             \
                                     PIN_ODR_HIGH(GPIOI_PIN1) |             \
                                     PIN_ODR_HIGH(GPIOI_PIN2) |             \
                                     PIN_ODR_HIGH(GPIOI_PIN3) |             \
                                     PIN_ODR_HIGH(GPIOI_PIN4) |             \
                                     PIN_ODR_HIGH(GPIOI_PIN5) |             \
                                     PIN_ODR_HIGH(GPIOI_PIN6) |             \
                                     PIN_ODR_HIGH(GPIOI_PIN7) |             \
                                     PIN_ODR_HIGH(GPIOI_PIN8) |             \
                                     PIN_ODR_HIGH(GPIOI_PIN9) |             \
                                     PIN_ODR_HIGH(GPIOI_PIN10) |            \
                                     PIN_ODR_HIGH(GPIOI_PIN11) |            \
                                     PIN_ODR_HIGH(GPIOI_PIN12) |            \
                                     PIN_ODR_HIGH(GPIOI_PIN13) |            \
                                     PIN_ODR_HIGH(GPIOI_PIN14) |            \
                                     PIN_ODR_HIGH(GPIOI_PIN15))
#define VAL_GPIOI_AFRL              (PIN_AFIO_AF(GPIOI_PIN0, 0) |           \
                                     PIN_AFIO_AF(GPIOI_PIN1, 0) |           \
                                     PIN_AFIO_AF(GPIOI_PIN2, 0) |           \
                                     PIN_AFIO_AF(GPIOI_PIN3, 0) |           \
                                     PIN_AFIO_AF(GPIOI_PIN4, 0) |           \
                                     PIN_AFIO_AF(GPIOI_PIN5, 0) |           \
                                     PIN_AFIO_AF(GPIOI_PIN6, 0) |           \
                                     PIN_AFIO_AF(GPIOI_PIN7, 0))
#define VAL_GPIOI_AFRH              (PIN_AFIO_AF(GPIOI_PIN8, 0) |           \
                                     PIN_AFIO_AF(GPIOI_PIN9, 0) |           \
                                     PIN_AFIO_AF(GPIOI_PIN10, 0) |          \
                                     PIN_AFIO_AF(GPIOI_PIN11, 0) |          \
                                     PIN_AFIO_AF(GPIOI_PIN12, 0) |          \
                                     PIN_AFIO_AF(GPIOI_PIN13, 0) |          \
                                     PIN_AFIO_AF(GPIOI_PIN14, 0) |          \
                                     PIN_AFIO_AF(GPIOI_PIN15, 0))

#if !defined(_FROM_ASM_)
#ifdef __cplusplus
extern "C" {
#endif
  void boardInit(void);
#ifdef __cplusplus
}
#endif
#endif /* _FROM_ASM_ */

#endif /* _BOARD_H_ */
