sebiik/axoloti-preenfm2/firmware/main.c

/**
 * Copyright (C) 2013, 2014 Johannes Taelman
 *
 * This file is part of Axoloti.
 *
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
 * You should have received a copy of the GNU General Public License along with
 * Axoloti. If not, see <http://www.gnu.org/licenses/>.
 */

#include "axoloti_defines.h"

#if (BOARD_AXOLOTI_V05)
#include "sdram.h"
#include "stm32f4xx_fmc.h"
#endif

#include "ch.h"
#include "hal.h"
#include "chprintf.h"
#include "shell.h"
#include "string.h"
#include <stdio.h>

#include "eeprom.h"
#include "codec.h"
#include "ui.h"
#include "midi.h"
#include "sdcard.h"
#include "patch.h"
#include "pconnection.h"
#include "axoloti_control.h"
#include "axoloti_math.h"
#include "axoloti_board.h"
#include "exceptions.h"
#include "watchdog.h"

#include "chprintf.h"
#include "usbcfg.h"
#include "sysmon.h"

#if (BOARD_AXOLOTI_V05)
#include "sdram.c"
#include "stm32f4xx_fmc.c"
#define ENABLE_USB_HOST
#endif
/*===========================================================================*/
/* Initialization and main thread.                                           */
/*===========================================================================*/


//#define ENABLE_SERIAL_DEBUG 1

#ifdef ENABLE_USB_HOST
#if (BOARD_AXOLOTI_V03)
#error conflicting pins: USB_OTG_HS and I2S
#endif
extern void MY_USBH_Init(void);
#endif

#if (BOARD_STM32F4DISCOVERY)
void ToggleGreen(void) {
  palSetPadMode(GPIOD, 12, PAL_MODE_OUTPUT_PUSHPULL); palTogglePad(GPIOD, 12);
}
void ToggleOrange(void) {
  palSetPadMode(GPIOD, 13, PAL_MODE_OUTPUT_PUSHPULL); palTogglePad(GPIOD, 13);
}
void ToggleRed(void) {
  palSetPadMode(GPIOD, 14, PAL_MODE_OUTPUT_PUSHPULL); palTogglePad(GPIOD, 14);
}
void ToggleBlue(void) {
  palSetPadMode(GPIOD, 15, PAL_MODE_OUTPUT_PUSHPULL); palTogglePad(GPIOD, 15);
}
#endif

int main(void) {
  // copy vector table to SRAM1!
#pragma GCC diagnostic push
#pragma GCC diagnostic ignored "-Wnonnull"
  memcpy((char *)0x20000000, (const char)0x00000000, 0x200);
#pragma GCC diagnostic pop
  // remap SRAM1 to 0x00000000
  SYSCFG->MEMRMP |= 0x03;

  halInit();
  chSysInit();

#if ((BOARD_AXOLOTI_V03) || (BOARD_AXOLOTI_V05) || (BOARD_PREENFM2))
  sdcard_init();
#endif
  sysmon_init();

#if ENABLE_SERIAL_DEBUG
// SD2 for serial debug output
#if ((BOARD_AUDIOTHINGIES_P6) || (BOARD_PREENFM2))
// GPIOA2/3 used for DIN_INH/LATCH on P6, and none of the other pins that are
// free can be assigned to any USART, but set one up anyway, using pins
// that are not available on the P6 MCU, to keep the software happy (TODO)
//seb TODO
  palSetPadMode(GPIOD, 6, PAL_MODE_ALTERNATE(7) | PAL_MODE_INPUT); // RX
  palSetPadMode(GPIOD, 5, PAL_MODE_OUTPUT_PUSHPULL); // TX
  palSetPadMode(GPIOD, 5, PAL_MODE_ALTERNATE(7)); // TX
#else
  palSetPadMode(GPIOA, 3, PAL_MODE_ALTERNATE(7) | PAL_MODE_INPUT); // RX
  palSetPadMode(GPIOA, 2, PAL_MODE_OUTPUT_PUSHPULL); // TX
  palSetPadMode(GPIOA, 2, PAL_MODE_ALTERNATE(7)); // TX
#endif
// 115200 baud
  static const SerialConfig sd2Cfg = {115200,
        0, 0, 0};
  sdStart(&SD2, &sd2Cfg);
  chprintf((BaseSequentialStream * )&SD2,"Hello world!\r\n");
#endif

  exception_init();

  InitPatch0();

  InitPConnection();

#ifndef BOARD_AUDIOTHINGIES_P6
  // PC.1 is LCD E on P6
  // display SPI CS?
  palSetPadMode(GPIOC, 1, PAL_MODE_OUTPUT_PUSHPULL);
  palSetPad(GPIOC, 1);
#endif

  chThdSleepMilliseconds(10);

  palSetPadMode(SW2_PORT, SW2_PIN, PAL_MODE_INPUT_PULLDOWN);

  axoloti_board_init();
#ifndef BOARD_AUDIOTHINGIES_P6
  adc_init();
#endif
#if ((BOARD_AUDIOTHINGIES_P6) || (BOARD_PREENFM2))
  eeprom_init(); //seb TODO
#endif
  axoloti_math_init();
  midi_init();
  start_dsp_thread();
  codec_init();

  if (!palReadPad(SW2_PORT, SW2_PIN)) { // button S2 not pressed
//    watchdog_init();
    chThdSleepMilliseconds(1);
  }

#if ((BOARD_AXOLOTI_V03)||(BOARD_AXOLOTI_V05))
  axoloti_control_init();
#endif
  ui_init();

#if (BOARD_AXOLOTI_V05)
// TODO: Remove sdram.c from build for P6
  configSDRAM();
  //memTest();
#endif

#ifdef ENABLE_USB_HOST
  MY_USBH_Init();
#endif

  if (!exception_check()) {
    // only try booting a patch when no exception is to be reported

#if ((BOARD_AXOLOTI_V03)||(BOARD_AXOLOTI_V05)||(BOARD_PREENFM2))
    sdcard_attemptMountIfUnmounted();
    if (fs_ready && !palReadPad(SW2_PORT, SW2_PIN)){
      // button S2 not pressed
      LoadPatchStartSD();
    }
#endif

    // if no patch booting or running yet
    // try loading from flash
    if (patchStatus == STOPPED) {
      if (!palReadPad(SW2_PORT, SW2_PIN)) // button S2 not pressed
        LoadPatchStartFlash();
    }
  }

  while (1) {
    chThdSleepMilliseconds(1000);
  }
}

void HAL_Delay(unsigned int n) {
  chThdSleepMilliseconds(n);
}

void _sbrk(void) {
  while (1) {
  }
}
