sebiik/axoloti-preenfm2/preenfm2-master/src/synth/Osc.cpp

/*
 * Copyright 2013 Xavier Hosxe
 *
 * Author: Xavier Hosxe (xavier . hosxe (at) gmail . com)
 *
 * This program is free software: you can redistribute it and/or modify
 * it under the terms of the GNU General Public License as published by
 * the Free Software Foundation, either version 3 of the License, or
 * (at your option) any later version.
 * This program is distributed in the hope that it will be useful,
 * but WITHOUT ANY WARRANTY; without even the implied warranty of
 * MERCHANTABILITY or FITNESS FOR A PARTICULAR PURPOSE.  See the
 * GNU General Public License for more details.
 * You should have received a copy of the GNU General Public License
 * along with this program.  If not, see <http://www.gnu.org/licenses/>.
 */

#include "Osc.h"

float silence[1]  __attribute__ ((section(".ccmnoload")));
float noise[32] __attribute__ ((section(".ccmnoload")));

#include "../waveforms/waves.c"

float *frequencyToUse;

float* Osc::oscValues[4] __attribute__ ((section(".ccmnoload")));
float oscValues1[32] __attribute__ ((section(".ccmnoload")));
float oscValues2[32] __attribute__ ((section(".ccmnoload")));
float oscValues3[32] __attribute__ ((section(".ccmnoload")));
float oscValues4[32] __attribute__ ((section(".ccmnoload")));
int Osc::oscValuesCpt = 1;

// User waveforms
float userWaveform[6][1024];

struct WaveTable waveTables[NUMBER_OF_WAVETABLES] __attribute__ ((section(".ccm"))) = {
        //		OSC_SHAPE_SIN = 0,
        {
                sinTable,
                0x7ff,
                1.0f,
                0.0f,
                0.0f
        },
        //		OSC_SHAPE_SAW,
        {
                sawTable,
                0x7ff,
                1.0f,
                0.0f,
                0.0f
        },
        //		OSC_SHAPE_SQUARE,
        {
                squareTable,
                0x7ff,
                1.0f,
                0.0f,
                0.0f
        },
        //		OSC_SHAPE_SIN_SQUARE,
        {
                sinSquareTable,
                0x3ff,
                1.0f,
                0.0f,
                0.0f
        },
        //		OSC_SHAPE_SIN_ZERO,
        {
                sinOrZeroTable,
                0x3ff,
                1.0f,
                0.0f,
                0.0f
        },
        //		OSC_SHAPE_SIN_POS,
        {
                sinPosTable,
                0x3ff,
                1.0f,
                0.0f,
                0.0f
        },
        //		OSC_SHAPE_RAND,
        {
                noise,
                0x1f,
                0.0f,
                1.0f,
                0.0f
        },
        //	OSC_SHAPE_OFF,
        {
                silence,
                0x00, // Must be 0 to reset index when switching from an other shape.
                0.0f,
                0.0f,
                0.0f
        },
        //  USER waveform 1
        {
                userWaveform[0],
                0x3ff,
                1.0f,
                0.0f,
                0.0f
        },
        //  USER waveform 2
        {
                userWaveform[1],
                0x3ff,
                1.0f,
                0.0f,
                0.0f
        },
        //  USER waveform 3
        {
                userWaveform[2],
                0x3ff,
                1.0f,
                0.0f,
                0.0f
        },
        //  USER waveform 4
        {
                userWaveform[3],
                0x3ff,
                1.0f,
                0.0f,
                0.0f
        },
        //  USER waveform 5
        {
                userWaveform[4],
                0x3ff,
                1.0f,
                0.0f,
                0.0f
        },
        //  USER waveform 6
        {
                userWaveform[5],
                0x3ff,
                1.0f,
                0.0f,
                0.0f
        }

};


void Osc::init(struct OscillatorParams *oscParams, DestinationEnum df) {
    silence[0] = 0;

    this->destFreq = df;
    this->oscillator = oscParams;

    if (waveTables[0].precomputedValue <= 0) {
        for (int k=0; k<NUMBER_OF_WAVETABLES; k++) {
            waveTables[k].precomputedValue = (waveTables[k].max + 1) * waveTables[k].useFreq * PREENFM_FREQUENCY_INVERSED;
        }
        // Set frequencyToUse  to frequency (no Scala scale defined)
        frequencyToUse = frequency;
    }
    if (oscValuesCpt == 1) {
        oscValues[0] = oscValues1;
        oscValues[1] = oscValues2;
        oscValues[2] = oscValues3;
        oscValues[3] = oscValues4;
        oscValuesCpt = 0;
    }
}

void Osc::newNote(struct OscState* oscState, int note) {

    oscState->index = waveTables[(int) oscillator->shape].max * .25f;
    switch ((int)oscillator->frequencyType) {
    case OSC_FT_KEYBOARD:
        oscState->mainFrequency = frequencyToUse[note] * oscillator->frequencyMul * (1.0f + oscillator->detune * .05f);
        break;
    case OSC_FT_FIXE:
        oscState->mainFrequency = oscillator->frequencyMul* 1000.0f + oscillator->detune * 100.0f;
        if (oscState->mainFrequency < 0.0f) {
            oscState->mainFrequency = 0.0f;
        }
        break;
    case OSC_FT_KEYHZ:
        oscState->mainFrequency = frequencyToUse[note] * oscillator->frequencyMul + oscillator->detune;
        break;
    }
    oscState->frequency = oscState->mainFrequency;
}


void Osc::glideToNote(struct OscState* oscState, int note) {
    switch ((int)oscillator->frequencyType) {
    case OSC_FT_KEYBOARD:
        oscState->nextFrequency = frequencyToUse[note] *  oscillator->frequencyMul  * (1.0f + oscillator->detune * .05f);
        break;
    case OSC_FT_FIXE:
        oscState->nextFrequency = oscState->mainFrequency;
        break;
    case OSC_FT_KEYHZ:
        oscState->nextFrequency = frequencyToUse[note] * oscillator->frequencyMul   + oscillator->detune;
        break;
    }
    oscState->fromFrequency = oscState->mainFrequency;
}


void Osc::glideStep(struct OscState* oscState, float phase) {
    oscState->mainFrequency = oscState->fromFrequency * (1 - phase) + oscState->nextFrequency * phase;
}

float exp2_harm[] = {
        /*-51.2*/ 0.051952368508924235,
        /*-51.1*/ 0.05225332551803182, /*-51*/ 0.052556025953357156, /*-50.9*/ 0.05286047991446555, /*-50.8*/ 0.05316669755942848, /*-50.7*/ 0.05347468910516262,
        /*-50.6*/ 0.05378446482777063, /*-50.5*/ 0.05409603506288395, /*-50.4*/ 0.05440941020600775, /*-50.3*/ 0.05472460071286783, /*-50.2*/ 0.05504161709975927,
        /*-50.1*/ 0.055360469943897546, /*-50*/ 0.0556811698837712, /*-49.9*/ 0.05600372761949703, /*-49.8*/ 0.05632815391317691, /*-49.7*/ 0.056654459589256904,
        /*-49.6*/ 0.056982655534888536, /*-49.5*/ 0.05731275270029195, /*-49.4*/ 0.05764476209912122, /*-49.3*/ 0.05797869480883184, /*-49.2*/ 0.05831456197105044,
        /*-49.1*/ 0.05865237479194644, /*-49*/ 0.05899214454260585, /*-48.9*/ 0.05933388255940744, /*-48.8*/ 0.059677600244401045, /*-48.7*/ 0.06002330906568776,
        /*-48.6*/ 0.06037102055780286, /*-48.5*/ 0.06072074632210035, /*-48.4*/ 0.061072498027140376, /*-48.3*/ 0.06142628740907821, /*-48.2*/ 0.06178212627205601,
        /*-48.1*/ 0.06214002648859669, /*-48*/ 0.0625, /*-47.9*/ 0.06286205881674084, /*-47.8*/ 0.06322621501887017, /*-47.7*/ 0.0635924807564179,
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
        /*-34.1*/ 0.1394996428287779, /*-34*/ 0.1403077560386716, /*-33.9*/ 0.14112055060076642, /*-33.8*/ 0.1419380536338597, /*-33.7*/ 0.1427602924138464,
        /*-33.6*/ 0.14358729437462936, /*-33.5*/ 0.14441908710903414, /*-33.4*/ 0.14525569836972996, /*-33.3*/ 0.1460971560701557, /*-33.2*/ 0.14694348828545106,
        /*-33.1*/ 0.14779472325339352, /*-33*/ 0.14865088937534013, /*-32.9*/ 0.14951201521717547, /*-32.8*/ 0.15037812951026464, /*-32.7*/ 0.15124926115241158,
        /*-32.6*/ 0.15212543920882385, /*-32.5*/ 0.1530066929130819, /*-32.4*/ 0.15389305166811457, /*-32.3*/ 0.15478454504718006, /*-32.2*/ 0.15568120279485284,
        /*-32.1*/ 0.15658305482801596, /*-32*/ 0.15749013123685915, /*-31.9*/ 0.15840246228588278, /*-31.8*/ 0.15932007841490778, /*-31.7*/ 0.16024301024009113,
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
