sebiik/axoloti-preenfm2/preenfm2-master/src/synth/Voice.h

/*
 * Copyright 2013 Xavier Hosxe
 *
 * Author: Xavier Hosxe (xavier . hosxe (at) gmail . com)
 *
 * This program is free software: you can redistribute it and/or modify
 * it under the terms of the GNU General Public License as published by
 * the Free Software Foundation, either version 3 of the License, or
 * (at your option) any later version.
 * This program is distributed in the hope that it will be useful,
 * but WITHOUT ANY WARRANTY; without even the implied warranty of
 * MERCHANTABILITY or FITNESS FOR A PARTICULAR PURPOSE.  See the
 * GNU General Public License for more details.
 * You should have received a copy of the GNU General Public License
 * along with this program.  If not, see <http://www.gnu.org/licenses/>.
 */

#ifndef VOICE_H_
#define VOICE_H_

#include "Timbre.h"
#include "Env.h"
#include "Osc.h"


class Timbre;


class Voice
{
    friend class Timbre;

public:
    Voice();
    ~Voice(void);

    void init();

    void nextBlock();

    void endNoteOrBeginNextOne();

    void noteOnWithoutPop(short note, short velocity, unsigned int index);
    void noteOn(short note, short velocity, unsigned int index);
    void glideToNote(short newNote);
    void killNow();
    void noteOff();
    void glideFirstNoteOff();
    void glide();

    bool isReleased() { return this->released; }
    bool isPlaying() { return this->playing; }
    bool isNewNotePending() { return this->newNotePending; }
    unsigned int getIndex() { return this->index; }
    char getNote() { return this->note; }
    char getNextPendingNote() { return this->nextPendingNote; }
    char getNextGlidingNote() { return this->nextGlidingNote; }
    bool isHoldedByPedal() { return this->holdedByPedal; }
    void setHoldedByPedal(bool holded) { this->holdedByPedal = holded; }
    void setCurrentTimbre(Timbre *timbre);    bool isGliding() { return gliding; }

    void updateAllModulationIndexes() {
        int numberOfIMs = algoInformation[(int)(currentTimbre->getParamRaw()->engine1.algo)].im;
        modulationIndex1 = currentTimbre->getParamRaw()->engineIm1.modulationIndex1 + matrix.getDestination(INDEX_MODULATION1) + matrix.getDestination(INDEX_ALL_MODULATION) + this->velIm1;
        if (unlikely(modulationIndex1 < 0.0f)) {
            modulationIndex1 = 0.0f;
        }
        modulationIndex2 = currentTimbre->getParamRaw()->engineIm1.modulationIndex2 + matrix.getDestination(INDEX_MODULATION2) + matrix.getDestination(INDEX_ALL_MODULATION) + this->velIm2;
        if (unlikely(modulationIndex2 < 0.0f)) {
            modulationIndex2 = 0.0f;
        }

        modulationIndex3 = currentTimbre->getParamRaw()->engineIm2.modulationIndex3 + matrix.getDestination(INDEX_MODULATION3) + matrix.getDestination(INDEX_ALL_MODULATION) + this->velIm3;
        if (unlikely(modulationIndex3 < 0.0f)) {
            modulationIndex3 = 0.0f;
        }

        if (likely(numberOfIMs < 3)) {
            return;
        }

        modulationIndex4 = currentTimbre->getParamRaw()->engineIm2.modulationIndex4 + matrix.getDestination(INDEX_MODULATION4) + matrix.getDestination(INDEX_ALL_MODULATION) + this->velIm4;
        if (unlikely(modulationIndex4 < 0.0f)) {
            modulationIndex4 = 0.0f;
        }

        modulationIndex5 = currentTimbre->getParamRaw()->engineIm3.modulationIndex5 + matrix.getDestination(INDEX_ALL_MODULATION) + this->velIm5;
        if (unlikely(modulationIndex5 < 0.0f)) {
            modulationIndex5 = 0.0f;
        }
    }

    void updateAllMixOscsAndPans() {
        int numberOfMixes = algoInformation[(int)(currentTimbre->getParamRaw()->engine1.algo)].mix;
        int mix;
        float inv65535 = .0000152587890625; // 1/ 65535

        mix1 = currentTimbre->getParamRaw()->engineMix1.mixOsc1 + matrix.getDestination(MIX_OSC1) + matrix.getDestination(ALL_MIX);
        // Optimization to check mix1 is between 0 and 1
        mix1 = __USAT((int)(mix1 * 65536) , 16) * inv65535;
        float pan1 = currentTimbre->getParamRaw()->engineMix1.panOsc1 + matrix.getDestination(PAN_OSC1) + matrix.getDestination(ALL_PAN) + 1.0f;
        // pan1 is between -1 and 1 : Scale from 0.0 to 256
        int pan = __USAT((int)(pan1 * 128), 8);
        pan1Left = panTable[256 - pan];
        pan1Right = panTable[pan];


        mix2 = currentTimbre->getParamRaw()->engineMix1.mixOsc2 + matrix.getDestination(MIX_OSC2) + matrix.getDestination(ALL_MIX);
        mix2 = __USAT((int)(mix2 * 65535) , 16) * inv65535;

        float pan2 = currentTimbre->getParamRaw()->engineMix1.panOsc2 + matrix.getDestination(PAN_OSC2) + matrix.getDestination(ALL_PAN) + 1.0f;
        pan = __USAT((int)(pan2 * 128), 8);
        pan2Left = panTable[256 - pan];
        pan2Right = panTable[pan];

        // A bit lighter for algo with 1 or 2 mix...
        if (numberOfMixes <=2) {
            return;
        }

        mix3 = currentTimbre->getParamRaw()->engineMix2.mixOsc3 + matrix.getDestination(MIX_OSC3) + matrix.getDestination(ALL_MIX);
        mix3 = __USAT((int)(mix3 * 65535) , 16) * inv65535;

        float pan3 = currentTimbre->getParamRaw()->engineMix2.panOsc3 + matrix.getDestination(PAN_OSC3) + matrix.getDestination(ALL_PAN) + 1.0f;
        pan = __USAT((int)(pan3 * 128), 8);
        pan3Left = panTable[256 - pan];
        pan3Right = panTable[pan];

        // No matrix for mix4 and pan4
        mix4 = currentTimbre->getParamRaw()->engineMix2.mixOsc4 + matrix.getDestination(ALL_MIX);
        mix4 = __USAT((int)(mix4 * 65535) , 16) * inv65535;
        float pan4 = currentTimbre->getParamRaw()->engineMix2.panOsc4 + matrix.getDestination(ALL_PAN) + 1.0f;
        pan = __USAT((int)(pan4 * 128), 8);
        pan4Left = panTable[256 - pan];
        pan4Right = panTable[pan];


        // A bit lighter for algo with 5 or 6 mix...
        if (likely(numberOfMixes <=4)) {
            return;
        }

        // No more matrix....

        mix5 = currentTimbre->getParamRaw()->engineMix3.mixOsc5  + matrix.getDestination(ALL_MIX);
        mix5 = __USAT((int)(mix5 * 65535) , 16) * inv65535;
        float pan5 = currentTimbre->getParamRaw()->engineMix3.panOsc5 + matrix.getDestination(ALL_PAN)  + 1.0f;
        pan = __USAT((int)(pan5 * 128), 8);
        pan5Left = panTable[256 - pan];
        pan5Right = panTable[pan];

        mix6 = currentTimbre->getParamRaw()->engineMix3.mixOsc6 + matrix.getDestination(ALL_MIX);
        mix6 = __USAT((int)(mix6 * 65535) , 16) * inv65535;
        float pan6 = currentTimbre->getParamRaw()->engineMix3.panOsc6 + matrix.getDestination(ALL_PAN) + 1.0f;
        pan = __USAT((int)(pan6 * 128), 8);
        pan6Left = panTable[256 - pan];
        pan6Right = panTable[pan];

    }


    void midiClockSongPositionStep(int songPosition, bool recomputeNext) {
        if (likely(currentTimbre->isLfoUsed(0))) {
            lfoOsc[0].midiClock(songPosition, recomputeNext);
        }
        if (likely(currentTimbre->isLfoUsed(1))) {
            lfoOsc[1].midiClock(songPosition, recomputeNext);
        }
        if (likely(currentTimbre->isLfoUsed(2))) {
            lfoOsc[2].midiClock(songPosition, recomputeNext);
        }
        if (likely(currentTimbre->isLfoUsed(3))) {
            lfoEnv[0].midiClock(songPosition, recomputeNext);
        }
        if (likely(currentTimbre->isLfoUsed(4))) {
            lfoEnv2[0].midiClock(songPosition, recomputeNext);
        }
        if (likely(currentTimbre->isLfoUsed(5))) {
            lfoStepSeq[0].midiClock(songPosition, recomputeNext);
        }
        if (likely(currentTimbre->isLfoUsed(6))) {
            lfoStepSeq[1].midiClock(songPosition, recomputeNext);
        }
    }

    void midiClockContinue(int songPosition) {
        if (likely(currentTimbre->isLfoUsed(0))) {
            lfoOsc[0].midiClock(songPosition, false);
        }
        if (likely(currentTimbre->isLfoUsed(1))) {
            lfoOsc[1].midiClock(songPosition, false);
        }
        if (likely(currentTimbre->isLfoUsed(2))) {
            lfoOsc[2].midiClock(songPosition, false);
        }
        if (likely(currentTimbre->isLfoUsed(3))) {
            lfoEnv[0].midiClock(songPosition, false);
        }
        if (likely(currentTimbre->isLfoUsed(4))) {
            lfoEnv2[0].midiClock(songPosition, false);
        }
        if (likely(currentTimbre->isLfoUsed(5))) {
            lfoStepSeq[0].midiClock(songPosition, false);
        }
        if (likely(currentTimbre->isLfoUsed(6))) {
            lfoStepSeq[1].midiClock(songPosition, false);
        }
    }


    void midiClockStart() {
        if (likely(currentTimbre->isLfoUsed(0))) {
            lfoOsc[0].midiContinue();
        }
        if (likely(currentTimbre->isLfoUsed(1))) {
            lfoOsc[1].midiContinue();
        }
        if (likely(currentTimbre->isLfoUsed(2))) {
            lfoOsc[2].midiContinue();
        }
        if (likely(currentTimbre->isLfoUsed(3))) {
            lfoEnv[0].midiContinue();
        }
        if (likely(currentTimbre->isLfoUsed(4))) {
            lfoEnv2[0].midiContinue();
        }
        if (likely(currentTimbre->isLfoUsed(5))) {
            lfoStepSeq[0].midiContinue();
        }
        if (likely(currentTimbre->isLfoUsed(6))) {
            lfoStepSeq[1].midiContinue();
        }
    }


    void lfoNoteOn() {
        if (likely(currentTimbre->isLfoUsed(0))) {
            lfoOsc[0].noteOn();
        }
        if (likely(currentTimbre->isLfoUsed(1))) {
            lfoOsc[1].noteOn();
        }
        if (likely(currentTimbre->isLfoUsed(2))) {
            lfoOsc[2].noteOn();
        }
        if (likely(currentTimbre->isLfoUsed(3))) {
            lfoEnv[0].noteOn();
        }
        if (likely(currentTimbre->isLfoUsed(4))) {
            lfoEnv2[0].noteOn();
        }
        if (likely(currentTimbre->isLfoUsed(5))) {
            lfoStepSeq[0].noteOn();
        }
        if (likely(currentTimbre->isLfoUsed(6))) {
            lfoStepSeq[1].noteOn();
        }
    }

    void lfoNoteOff() {
        if (likely(currentTimbre->isLfoUsed(0))) {
            lfoOsc[0].noteOff();
        }
        if (likely(currentTimbre->isLfoUsed(1))) {
            lfoOsc[1].noteOff();
        }
        if (likely(currentTimbre->isLfoUsed(2))) {
            lfoOsc[2].noteOff();
        }
        if (likely(currentTimbre->isLfoUsed(3))) {
            lfoEnv[0].noteOff();
        }
        if (likely(currentTimbre->isLfoUsed(4))) {
            lfoEnv2[0].noteOff();
        }
        if (likely(currentTimbre->isLfoUsed(5))) {
            lfoStepSeq[0].noteOff();
        }
        if (likely(currentTimbre->isLfoUsed(6))) {
            lfoStepSeq[1].noteOff();
        }
    }

    void prepareMatrixForNewBlock() {

        if (likely(currentTimbre->isLfoUsed(0))) {
            this->lfoOsc[0].nextValueInMatrix();
        }
        if (likely(currentTimbre->isLfoUsed(1))) {
            this->lfoOsc[1].nextValueInMatrix();
        }
        if (likely(currentTimbre->isLfoUsed(2))) {
            this->lfoOsc[2].nextValueInMatrix();
        }
        if (likely(currentTimbre->isLfoUsed(3))) {
            this->lfoEnv[0].nextValueInMatrix();
        }
        if (likely(currentTimbre->isLfoUsed(4))) {
            this->lfoEnv2[0].nextValueInMatrix();
        }
        if (likely(currentTimbre->isLfoUsed(5))) {
            this->lfoStepSeq[0].nextValueInMatrix();
        }
        if (likely(currentTimbre->isLfoUsed(6))) {
            this->lfoStepSeq[1].nextValueInMatrix();
        }

        this->matrix.computeAllDestintations();
        updateAllModulationIndexes();
    }


    void afterNewParamsLoad() {
        this->matrix.resetSources();
        this->matrix.resetAllDestination();
        for (int j=0; j<NUMBER_OF_ENCODERS; j++) {
            this->lfoOsc[0].valueChanged(j);
            this->lfoOsc[1].valueChanged(j);
            this->lfoOsc[2].valueChanged(j);
            this->lfoEnv[0].valueChanged(j);
            this->lfoEnv2[0].valueChanged(j);
            this->lfoStepSeq[0].valueChanged(j);
            this->lfoStepSeq[1].valueChanged(j);

        }
    }


    void lfoValueChange(int currentRow, int encoder, float newValue) {
        switch (currentRow) {
        case ROW_LFOOSC1:
        case ROW_LFOOSC2:
        case ROW_LFOOSC3:
            lfoOsc[currentRow - ROW_LFOOSC1].valueChanged(encoder);
            break;
        case ROW_LFOENV1:
            lfoEnv[0].valueChanged(encoder);
            break;
        case ROW_LFOENV2:
            lfoEnv2[0].valueChanged(encoder);
            break;
        case ROW_LFOSEQ1:
        case ROW_LFOSEQ2:
            lfoStepSeq[currentRow - ROW_LFOSEQ1].valueChanged(encoder);
            break;
        }
    }


private:
    // voice status
    int frequency;
    bool released;
    bool playing;
    unsigned int index;
    char note;
    float velocity;
    float velIm1, velIm2, velIm3, velIm4, velIm5;
    bool newNotePlayed;
    //
    float freqAi, freqAo;
    float freqBi, freqBo;
    // Harm freq shifting
    float freqHarm, targetFreqHarm;

    EnvData envState1;
    EnvData envState2;
    EnvData envState3;
    EnvData envState4;
    EnvData envState5;
    EnvData envState6;

    OscState oscState1;
    OscState oscState2;
    OscState oscState3;
    OscState oscState4;
    OscState oscState5;
    OscState oscState6;

    bool holdedByPedal;
    // Fixing the "plop" when all notes are buisy...
    bool newNotePending;
    char nextPendingNote;
    char nextVelocity;
    unsigned int nextIndex;

    // Gliding ?
    bool gliding;
    float glidePhase;
    char nextGlidingNote;

    // env Value
    float env1ValueMem;
    float env2ValueMem;
    float env3ValueMem;
    float env4ValueMem;
    float env5ValueMem;
    float env6ValueMem;

    Timbre* currentTimbre;

    // glide phase increment
    static float glidePhaseInc[10];

    // Matrix....
    Matrix matrix;

    // optimization
    float modulationIndex1, modulationIndex2, modulationIndex3, modulationIndex4, modulationIndex5;
    float mix1, mix2, mix3, mix4, mix5, mix6;
    float pan1Left, pan2Left, pan3Left, pan4Left, pan5Left, pan6Left  ;
    float pan1Right, pan2Right, pan3Right, pan4Right, pan5Right, pan6Right ;

    //
    LfoOsc lfoOsc[NUMBER_OF_LFO_OSC];
    LfoEnv lfoEnv[NUMBER_OF_LFO_ENV];
    LfoEnv2 lfoEnv2[NUMBER_OF_LFO_ENV2];
    LfoStepSeq lfoStepSeq[NUMBER_OF_LFO_STEP];


};

#endif
