sebiik/axoloti-preenfm2/firmware/codec_PT8211.c

/**
 * Copyright (C) 2013, 2014 Johannes Taelman
 * Copyright (C) 2016, Ricard Wanderlof
 *
 * This file is part of Axoloti.
 *
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
 * You should have received a copy of the GNU General Public License along with
 * Axoloti. If not, see <http://www.gnu.org/licenses/>.
 */

/*
 * Adapted from codec_CS43L22.c
 * Created on: Jun 7, 2012
 * Author: Kumar Abhishek
 */

#include "codec.h"
#include "codec_PT8211.h"

/******************  Bit definition for SPI_I2SCFGR register//seb addon  *****************/
/* RM0008-ism: CR1 has "CPOL", I2SCFGR has "CKPOL". */

#define SPI_I2SCFGR_I2SMOD_BIT          11
#define SPI_I2SCFGR_PCMSYNC_BIT         7
#define SPI_I2SCFGR_CKPOL_BIT           3
#define SPI_I2SCFGR_CHLEN_BIT           0

#define SPI_I2SCFGR_I2SMOD_SPI          (0x0 << SPI_I2SCFGR_I2SMOD_BIT)
#define SPI_I2SCFGR_I2SMOD_I2S          (0x1 << SPI_I2SCFGR_I2SMOD_BIT)
#define SPI_I2SCFGR_I2SCFG              (0x3 << 8)
#define SPI_I2SCFGR_I2SCFG_SLAVE_TX     (0x0 << 8)
#define SPI_I2SCFGR_I2SCFG_SLAVE_RX     (0x1 << 8)
#define SPI_I2SCFGR_I2SCFG_MASTER_TX    (0x2 << 8)
#define SPI_I2SCFGR_I2SCFG_MASTER_RX    (0x3 << 8)
#define SPI_I2SCFGR_PCMSYNC_SHORT       (0x0 << SPI_I2SCFGR_PCMSYNC_BIT)
#define SPI_I2SCFGR_PCMSYNC_LONG        (0x1 << SPI_I2SCFGR_PCMSYNC_BIT)
#define SPI_I2SCFGR_I2SSTD              (0x3 << 4)
#define SPI_I2SCFGR_I2SSTD_PHILLIPS     (0x0 << 4)
#define SPI_I2SCFGR_I2SSTD_MSB          (0x1 << 4)
#define SPI_I2SCFGR_I2SSTD_LSB          (0x2 << 4)
#define SPI_I2SCFGR_I2SSTD_PCM          (0x3 << 4)
#define SPI_I2SCFGR_CKPOL_LOW           (0x0 << SPI_I2SCFGR_CKPOL_BIT)
#define SPI_I2SCFGR_CKPOL_HIGH          (0x1 << SPI_I2SCFGR_CKPOL_BIT)
#define SPI_I2SCFGR_DATLEN              (0x3 << 1)
#define SPI_I2SCFGR_DATLEN_16_BIT       (0x0 << 1)
#define SPI_I2SCFGR_DATLEN_24_BIT       (0x1 << 1)
#define SPI_I2SCFGR_DATLEN_32_BIT       (0x2 << 1)
#define SPI_I2SCFGR_CHLEN_16_BIT        (0x0 << SPI_I2SCFGR_CHLEN_BIT)
#define SPI_I2SCFGR_CHLEN_32_BIT        (0x1 << SPI_I2SCFGR_CHLEN_BIT)

const stm32_dma_stream_t* i2sdma;
static uint32_t i2stxdmamode = 0;

#define I2S3_TX_DMA_CHANNEL \
STM32_DMA_GETCHANNEL(STM32_SPI_SPI3_TX_DMA_STREAM, \
STM32_SPI3_TX_DMA_CHN)

static void dma_i2s_interrupt(void* dat, uint32_t flags) {
  (void)dat;
  (void)flags;

  if ((i2sdma)->stream->CR & STM32_DMA_CR_CT) {
    computebufI(rbuf, buf);
  }
  else {
    computebufI(rbuf2, buf2);
  }
  dmaStreamClearInterrupt(i2sdma);
}

static void codec_PT8211_dma_init(void) {
  i2sdma = STM32_DMA_STREAM(STM32_SPI_SPI3_TX_DMA_STREAM);

  i2stxdmamode = STM32_DMA_CR_CHSEL(I2S3_TX_DMA_CHANNEL)
      | STM32_DMA_CR_PL(STM32_SPI_SPI3_DMA_PRIORITY) | STM32_DMA_CR_DIR_M2P
      | STM32_DMA_CR_TEIE | STM32_DMA_CR_TCIE | STM32_DMA_CR_DBM | // double buffer mode
      STM32_DMA_CR_PSIZE_HWORD | STM32_DMA_CR_MSIZE_WORD;

  dmaStreamAllocate(i2sdma, STM32_SPI_SPI3_IRQ_PRIORITY,
                    (stm32_dmaisr_t)dma_i2s_interrupt, (void *)&SPID3);

  dmaStreamSetPeripheral(i2sdma, &(SPI3->DR));
  dmaStreamSetMemory0(i2sdma, buf);
  dmaStreamSetMemory1(i2sdma, buf2);
  dmaStreamSetTransactionSize(i2sdma, 64);
  dmaStreamSetMode(i2sdma, i2stxdmamode | STM32_DMA_CR_MINC);
  dmaStreamClearInterrupt(i2sdma);
  dmaStreamEnable(i2sdma);
}

void codec_PT8211_i2s_init_48k(void) {
  palSetPadMode(GPIOA, 4, PAL_MODE_OUTPUT_PUSHPULL);
  palSetPadMode(GPIOA, 4, PAL_MODE_ALTERNATE(6)); /* WS */
  palSetPadMode(GPIOB, 3, PAL_MODE_ALTERNATE(6)); /* CLK */
  //seb: PC12 was conflicting with SDIO, is PB5 now
  //palSetPadMode(GPIOC, 12, PAL_MODE_ALTERNATE(6)); /* SD */
  palSetPadMode(GPIOB, 5, PAL_MODE_ALTERNATE(6)); /* SD */ //seb
  palSetPadMode(GPIOC, 7, PAL_MODE_ALTERNATE(6)); /* MCLK */

// SPI3 in I2S Mode, Master, MCLK=256*fs
  CODEC_I2S_ENABLE;

  // CODEC_I2S->I2SCFGR =  SPI_I2SCFGR_I2SMOD |
  //                       SPI_I2SCFGR_I2SCFG_1 |
  //                       SPI_I2SCFGR_DATLEN_1;

  CODEC_I2S->I2SCFGR =  SPI_I2SCFGR_I2SMOD_I2S |
                        SPI_I2SCFGR_I2SCFG_MASTER_TX |
                        SPI_I2SCFGR_I2SSTD_LSB  |
                        SPI_I2SCFGR_CKPOL_LOW | //seb try high?
                        SPI_I2SCFGR_DATLEN_16_BIT |
                        SPI_I2SCFGR_CHLEN_16_BIT;

  CODEC_I2S->I2SPR =  SPI_I2SPR_MCKOE |
                      SPI_I2SPR_ODD |
                      3;

  codec_PT8211_dma_init();

  CODEC_I2S->CR2 = SPI_CR2_TXDMAEN;

  CODEC_I2S->I2SCFGR |= SPI_I2SCFGR_I2SE;
}
