sebiik/axoloti-preenfm2/firmware/sdcard.c

/**
 * Copyright (C) 2013, 2014 Johannes Taelman
 *
 * This file is part of Axoloti.
 *
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
 * You should have received a copy of the GNU General Public License along with
 * Axoloti. If not, see <http://www.gnu.org/licenses/>.
 */
#include "ch.h"
#include "hal.h"
#include "chprintf.h"
#include "shell.h"
#include "ff.h"
#include "patch.h"
#include "sdcard.h"
#include <string.h>
#include "chprintf.h"
#include "exceptions.h"

/*===========================================================================*/
/* SDCard                                                                    */
/*===========================================================================*/

/* FS object.*/
FATFS SDC_FS;

/* FS mounted and ready.*/
bool_t fs_ready = FALSE;

/*===========================================================================*/
/* Card insertion monitor.                                                   */
/*===========================================================================*/

#define POLLING_INTERVAL                10
#define POLLING_DELAY                   10

/**
 * @brief   Card monitor timer.
 */
static VirtualTimer tmr;

/**
 * @brief   Debounce counter.
 */
static unsigned cnt;

/**
 * @brief   Card event sources.
 */
static EventSource inserted_event, removed_event;
#if 1
/**
 * @brief   Insertion monitor timer callback function.
 *
 * @param[in] p         pointer to the @p BaseBlockDevice object
 *
 * @notapi
 */
static void tmrfunc(void *p) {
  BaseBlockDevice *bbdp = p;

  chSysLockFromIsr();
  if (cnt > 0) {
    if (blkIsInserted(bbdp)) {
      if (--cnt == 0) {
        chEvtBroadcastI(&inserted_event);
      }
    }
    else
      cnt = POLLING_INTERVAL;
  }
  else {
    if (!blkIsInserted(bbdp)) {
      cnt = POLLING_INTERVAL;
      chEvtBroadcastI(&removed_event);
    }
  }
  chVTSetI(&tmr, MS2ST(POLLING_DELAY), tmrfunc, bbdp);
  chSysUnlockFromIsr();
}

/**
 * @brief   Polling monitor start.
 *
 * @param[in] p         pointer to an object implementing @p BaseBlockDevice
 *
 * @notapi
 */
static void tmr_init(void *p) {

  chEvtInit(&inserted_event);
  chEvtInit(&removed_event);
  chSysLock();
  cnt = POLLING_INTERVAL;
  chVTSetI(&tmr, MS2ST(POLLING_DELAY), tmrfunc, p);
  chSysUnlock();
}

/*
 * Card insertion event.
 */
static void InsertHandler(eventid_t id) {
  FRESULT err;

  (void)id;
  /*
   * On insertion SDC initialization and FS mount.
   */
  if (fs_ready) {
    sdcDisconnect(&SDCD1);
    fs_ready = FALSE;
  }

  if (sdcConnect(&SDCD1))
    return;

  err = f_mount(0, &SDC_FS);
  if (err != FR_OK) {
    sdcDisconnect(&SDCD1);
    return;
  }
  fs_ready = TRUE;
}

/*
 * Card removal event.
 */
static void RemoveHandler(eventid_t id) {

  (void)id;
  sdcDisconnect(&SDCD1);
  fs_ready = FALSE;
}
#endif

void sdcard_init(void) {
  /*
   static const evhandler_t evhndl[] = {
   InsertHandler,
   RemoveHandler
   };
   struct EventListener el0, el1;
   */
#if ((BOARD_AXOLOTI_V03)||(BOARD_AXOLOTI_V05) || (BOARD_PREENFM2))
  palSetPadMode(GPIOC, 8, PAL_STM32_MODE_ALTERNATE | PAL_STM32_OSPEED_MID2 | PAL_STM32_ALTERNATE(12)); //seb
  palSetPadMode(GPIOC, 9, PAL_STM32_MODE_ALTERNATE | PAL_STM32_OSPEED_MID2 | PAL_STM32_ALTERNATE(12)); //seb hacked onto preenfm2 board
  palSetPadMode(GPIOC, 10, PAL_STM32_MODE_ALTERNATE | PAL_STM32_OSPEED_MID2 | PAL_STM32_ALTERNATE(12));
  palSetPadMode(GPIOC, 11, PAL_STM32_MODE_ALTERNATE | PAL_STM32_OSPEED_MID2 | PAL_STM32_ALTERNATE(12));
  palSetPadMode(GPIOC, 12, PAL_STM32_MODE_ALTERNATE | PAL_STM32_OSPEED_MID2 | PAL_STM32_ALTERNATE(12));
  palSetPadMode(GPIOD, 2, PAL_STM32_MODE_ALTERNATE | PAL_STM32_OSPEED_MID2 | PAL_STM32_ALTERNATE(12));

  chThdSleepMilliseconds(50);
  sdcStart(&SDCD1, NULL);

  chThdSleepMilliseconds(50);

  InsertHandler(0);

  FRESULT err;
  uint32_t clusters;
  FATFS *fsp;

  err = f_getfree("/", &clusters, &fsp);
  int retries = 3;
  while (err != FR_OK) {
    InsertHandler(0);
    chThdSleepMilliseconds(20);
    err = f_getfree("/", &clusters, &fsp);
    chThdSleepMilliseconds(50);
    retries--;
    if (!retries)
      break;
  }
#endif
}

void sdcard_attemptMountIfUnmounted() {
#if ((BOARD_AXOLOTI_V03)||(BOARD_AXOLOTI_V05)||(BOARD_PREENFM2))
  if (fs_ready)
    return;
  InsertHandler(0);
#endif
}

void sdcard_unmount(void){
  RemoveHandler(0);
}

/* Generic large buffer.*/
uint32_t fbuff[256] __attribute__ ((section (".sram2")));

int sdcard_loadPatch1(char *fname) {
  FIL FileObject;
  FRESULT err;
  uint32_t bytes_read;

  StopPatch();

//  LogTextMessage("load %s",fname);

  // change working directory

  int i=0;
  for(i=strlen(fname);i;i--){
    if (fname[i]=='/')
      break;
  }
  if (i>0) {
    fname[i]=0;
//    LogTextMessage("chdir %s",fname);
    err = f_chdir(fname);
    if (err != FR_OK) {
      report_fatfs_error(err,fname);
      return -1;
    }
    fname = &fname[i+1];
  } else {
    f_chdir("/");
  }

  err = f_open(&FileObject, fname, FA_READ | FA_OPEN_EXISTING);
  chThdSleepMilliseconds(10);
  if (err != FR_OK) {
	report_fatfs_error(err,fname);
    return -1;
  }
  err = f_read(&FileObject, (uint8_t *)PATCHMAINLOC, 0xE000,
               (void *)&bytes_read);
  if (err != FR_OK) {
    report_fatfs_error(err,fname);
    return -1;
  }
  err = f_close(&FileObject);
  if (err != FR_OK) {
    report_fatfs_error(err,fname);
    return -1;
  }
  chThdSleepMilliseconds(10);
  return 0;
}
