sebiik/axoloti-preenfm2/preenfm2-master/src/synth/Env.cpp

/*
 * Copyright 2013 Xavier Hosxe
 *
 * Author: Xavier Hosxe (xavier . hosxe (at) gmail . com)
 *
 * This program is free software: you can redistribute it and/or modify
 * it under the terms of the GNU General Public License as published by
 * the Free Software Foundation, either version 3 of the License, or
 * (at your option) any later version.
 * This program is distributed in the hope that it will be useful,
 * but WITHOUT ANY WARRANTY; without even the implied warranty of
 * MERCHANTABILITY or FITNESS FOR A PARTICULAR PURPOSE.  See the
 * GNU General Public License for more details.
 * You should have received a copy of the GNU General Public License
 * along with this program.  If not, see <http://www.gnu.org/licenses/>.
 */

#include "Env.h"

// Standard 128kb memory
float Env::incTab[1601];
int Env::initTab = 0;


float envLinear[] = { 0.0f, 1.0f};

float envExponential[] = {
		0.000000,0.062148,0.120174,0.174684,0.225892,0.273997,0.319188,0.361640,
		0.401521,0.438985,0.474180,0.507242,0.538301,0.567478,0.594887,0.620636,
		0.644825,0.667548,0.688895,0.708948,0.727786,0.745483,0.762108,0.777725,
		0.792397,0.806179,0.819126,0.831289,0.842715,0.853449,0.863532,0.873005,
		0.881903,0.890263,0.898115,0.905493,0.912423,0.918933,0.925049,0.930794,
		0.936192,0.941262,0.946025,0.950499,0.954703,0.958651,0.962361,0.965846,
		0.969119,0.972195,0.975083,0.977797,0.980347,0.982742,0.984992,0.987105,
		0.989091,0.990956,0.992708,0.994354,0.995901,0.997353,0.998718,1.000000
};


void Env::init(struct EnvelopeParamsA *envParamsA, struct EnvelopeParamsB *envParamsB, uint8_t envNumber, float* algoNumber) {
	this->envParamsA = envParamsA;
	this->envParamsB = envParamsB;
	this->envNumber = envNumber;
	this->algoNumber = algoNumber;

    if (initTab == 0) {
        initTab = 1;
        for (float k=1.0f; k<1601; k += 1.0f) {
            incTab[(int)(k + .005f)] = BLOCK_SIZE / PREENFM_FREQUENCY / (k / 100.0f);
        }
        // 1.0 to recognize it...
        incTab[0] = 1.0f;
    }

    // Init All ADSR
	for (int k=0; k<4; k++) {
		reloadADSR(k);
		reloadADSR(k + 4);
	}
}
