sebiik/axoloti-preenfm2/(commit log)

2019-06-20 add BOARD_PREENFM2 option to defines
2019-06-21 commented out some pin assigments
2019-06-26 fork board_preenfm2.h file, include preenfm2 repository for reference
    [CV_converter_v06.brd, CV_converter_v06.sch, ConfigurationFile.h, Preen40.brd, Preen40.kicad_pcb, Preen40.sch, PreenFM-2019-03-21-15-27-30.sch, PreenFM-2019-04-16-11-34-17.sch]
2019-07-02 design daughterboard for CS4354 DAC
    [PreenFM.kicad_pcb, PreenFM.sch, axo-on-preenfm2-pinout.xlsx, cs4354-daughterboard.kicad_pcb, cs4354-daughterboard.sch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]
2019-07-02 renamed kicad daughterboard 'noDIL'
    [cs4354-daughterboard.kicad_pcb, cs4354-daughterboard.sch, cs4354-daughterboard_noDIL.kicad_pcb, cs4354-daughterboard_noDIL.sch]
2019-07-05 change I2S codec to CS4354 DAC
    [PreenFM.sch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]
2019-10-04 cs4354 daughterboard fix, axo-preenfm2 analog input now working
    [axo-on-preenfm2-pinout.xlsx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]
